implementedrobotics/Nomad/Hardware/Actuator/NomadBLDC/PCBV1.3_CSD/3d_partially_populated.png

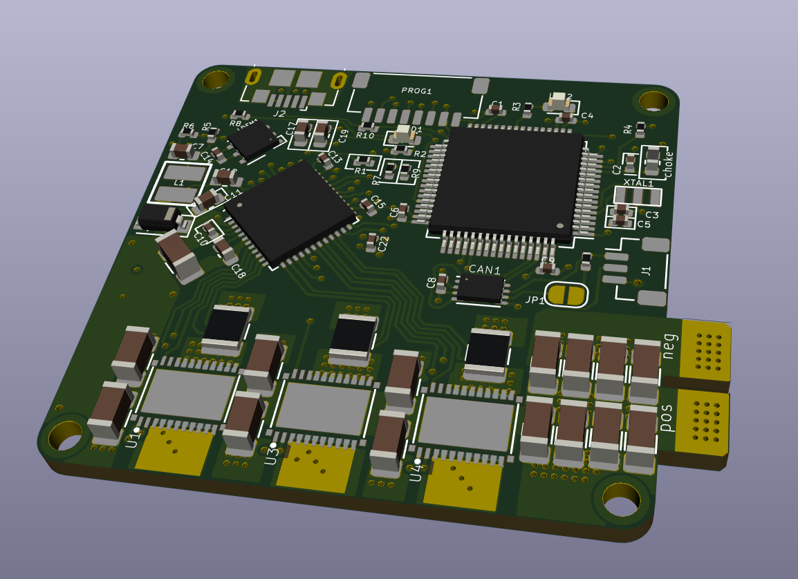
Hardware/Actuator/NomadBLDC/PCBV1.3_CSD/3d_partially_populated.png
