implementedrobotics/Nomad/README.md

# NOMAD
NOMAD is a 12-DOF quadruped walking robot using Linear and Nonlinear Optimization Control techniques.

  - Linear and Nonlinear Model Predictive Control
  - Simultaneous Localization and Mapping
  - Remote Control Teleoperation

# Software Installation

First thing to do is setup your software/development environment to build the source code:
[Software Setup](https://github.com/implementedrobotics/Nomad/tree/master/Software).

# Hardware Installation
