implementedrobotics/Nomad/Hardware/Actuator/NomadBLDC/PCBV1.3_CSD/README.md

# File structure
* Directory - KICAD
** Contains all files for the kicad project
* Directory - KICAD_READERS
** python macros that generated BOM lists for PCBA
* Directory - GERBERS
** plots for PCBA

# Updates from original BK board
* converted from eagle to kicad
* re-routed nearly all traces
* added [CSD88599Q5DC](http://www.ti.com/lit/ds/symlink/csd88599q5dc.pdf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) half-bridge FET
* added more caps
* added power terminal tabs for easier soldering
* added jumper to enable/disable 120 ohm CAN terminating resistor
* added USB connector
* added I/O pin to programming connector
* simplified mask to read all components
