implementedrobotics/Nomad/Hardware/Actuator/NomadBLDC/PCBV1.3_CSD/PCB_LAYERS.pdf

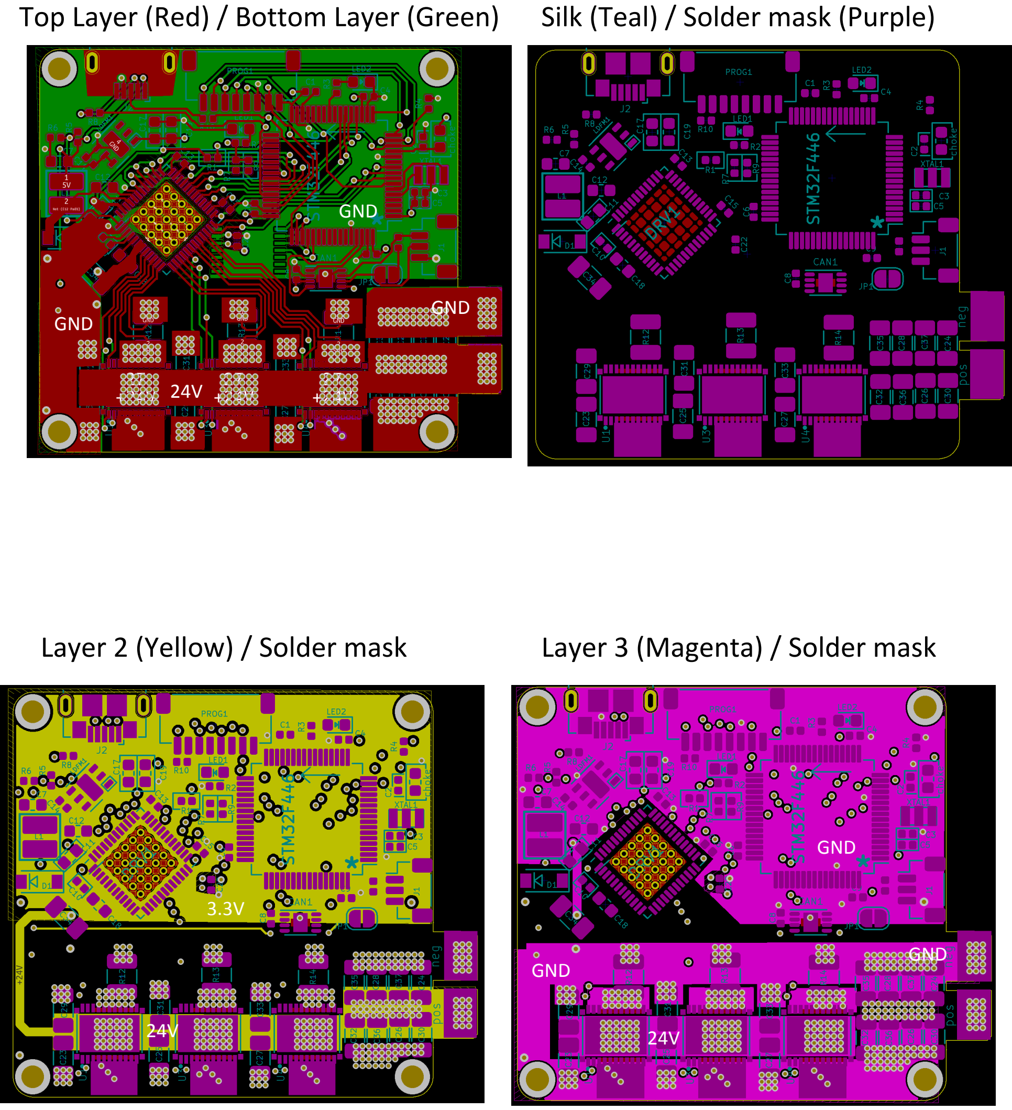
[picture p2: page 1]

Top Layer (Red) / Bottom Layer (Green) Silk (Teal) / Solder mask (Purple)

Layer 2 (Yellow) / Solder mask | Layer 3 (Magenta) / Solder mask

GND

24V

GND

GND

3.3V

24V

GND

24V

GND

GND
