implementedrobotics/Nomad/Hardware/Actuator/NomadBLDC/PCBV1.3_CSD/BOM_PCBWay.xlsx

Source | /Users/owhite/Documents/kicad/PCB_V1.3_CSD/PCB_V1.3_CSD.sch
Date: | Saturday, October 05, 2019 at 09:08:56 PM
Tool: | Eeschema (5.1.4-0-10_14)
Generator: | ./kicad_BOM.py
Component Count: | 66
width (mm): | 43.1
height (mm): | 40.96
Collated Components: | 29
Item # | *Ref Des | *Qty | Manufacturer | *Mfg Part # | Description / Value | *Package | Type | Your Instructions / Notes
1 | C1 | 1 | Murata Electronics | GRM155R60J475ME87D | 4.7uF | C0402 | SMD
2 | C2, C4, C5, C6, C8, C9, C15, C22 | 8 | KEMET | C0402C104K8PAC7411 | 0.1uF | C0402 | SMD
3 | C3, C13 | 2 | KEMET | C0402C105K8PACTU | 1uF | C0402 | SMD
4 | C7 | 1 | Murata Electronics | GRM188R61A226ME15J | 22uF | C0603 | SMD
5 | C10 | 1 | Yageo | CC0402JRX7R9BB473 | 47nF, 50v | C0402 | SMD
6 | C11, C12 | 2 | Yageo | CC0603JRX7R9BB104 | .1uF, 50v | C0603 | SMD
7 | C14 | 1 | KEMET | C0402C105K8PACTU | 1uf | C0402 | SMD
8 | C17, C19 | 2 | Murata Electronics | GRM188R61A226ME15J | 22uf | C0603 | SMD
9 | C18 | 1 | TDK | CGA3E3X5R1H105K080AB | 1uF, 50v | C0603 | SMD
10 | C23, C24, C25, C26, C27, C28, C29, C30, C31, C32, C33, C34, C35, C36, C37 | 15 | Murata Electronics | GRT31CR61H106ME01L | 10uF, 50v | C1206 | SMD
11 | CAN1 | 1 | Microchip Technology | MCP2542FDT-H/MNY | MCP2542 | TDFN-8 | SMD
12 | CHOKE1 | 1 | Pulse Electronics | PE-0603FB601ST | 600r | L0603 | SMD
13 | D1 | 1 | Diodes Incorporated | MBR0580S1-7 | DIODE | DSOD-123 | SMD
14 | DRV1 | 1 | Texas Instruments | DRV8323RSRGZT | DRV8323RH | TexasS-PVQFN-N48EP5.15x5.15mmIslands | SMD
15 | J1 | 1 | JST Sales America Inc. | BM03B-SURS-TF(LF)(SN) | Conn_01x03 | JSTSHBM03B-SRSS-TB1x03-1MPP1.00mmVertical | SMD
16 | J2 | 1 | GCT | USB3076-30-A | USB_B_Micro | USBMicro-BGCTUSB3076-30-A | SMD
17 | L1 | 1 | Taiyo Yuden | NRH3012T220MNV | 22uH | SDR0302 | SMD
18 | LDFM1 | 1 | STMicroelectronics | LDFM33PUR | LDFM | DFN-6 | SMD
19 | LED1, LED2 | 2 | Lite-On | LTST-C191KRKT | LED | LED0603 | SMD
20 | PROG1 | 1 | JST Sales America Inc. | SM08B-SRSS-TB(LF)(SN) | Conn_01x08 | JSTSHSM08B-SRSS-TB1x08-1MPP1.00mmHorizontal | SMD
21 | R1 | 1 | Yageo | RC0402DR-07150KL | 150k | R0402 | SMD
22 | R2, R3, TERM1 | 3 | Yageo | RC0402JR-07200RL | 200 | R0402 | SMD
23 | R4, R6, R7, R9 | 4 | Yageo | RT0402DRE0710KL | 10k | R0402 | SMD
24 | R5 | 1 | Yageo | RC0402FR-0754K9L | 54.9k | R0402 | SMD
25 | R8, R10 | 2 | Yageo | RC0402JR-0722RL | 22 | R0402 | SMD
26 | R12, R13, R14 | 3 | ROHM Semiconductor | PMR25HZPFV1L00 | 0.001 | R1210 | SMD
27 | STM1 | 1 | STMicroelectronics | STM32F446RET6 | STM32F446RET6 | TQFP-64 | SMD
28 | U1, U3, U4 | 3 | Texas Instruments | CSD88599Q5DC | CSD88599Q5DC | MOSFETCSD88599Q5DC | SMD
29 | XTAL1 | 1 | Murata Electronics | CSTNE8M00GH5L000R0 | CSTCE | CSTCE | SMD
