implementedrobotics/Nomad/Hardware/Actuator/NomadBLDC/PCB_V1.2/BOMs/BLDC_BOM_OW.xlsx

Sheet: SORTED
BK_PARTS refers to Ben Katz's original BOM
NUMBER | BK_PARTS | V1.2 | VALUE | PACKAGE
1 | R2, R3, R4 R27 | R1, R2, R5, R6 | 10k | R0402 | LINK (https://www.mouser.com/ProductDetail/603-RT0402DRE0710KL)
2 | R26 | R3 | 150k | R0402 | LINK (https://www.mouser.com/ProductDetail/603-RC0402DR-07150KL)
3 | R5, R22 | R9, R10 | 200ohm | R0402 | LINK (https://www.mouser.com/ProductDetail/603-RC0402JR-07200RL)
4 | R1 | R4 | 54.9k | R0402 | LINK (https://www.mouser.com/ProductDetail/603-RC0402FR-0754K9L)
5 | R6, R7 | R7, R8 | 0.001 | R1210 | LINK (https://www.mouser.com/ProductDetail/755-PMR25HZPFV1L00)
6 | C18, C27, C31, C32, C33, C34, C41, VREFCAP, VCAP1, VCAP2, VCAP3 | C26, C20, C21, C22, C28, C27, C11, C18, VCAP1, VCAP2, VCAP3 | .1uF 10v | C0402 | LINK (https://www.mouser.com/ProductDetail/80-C0402C104K8P7411)
7 | C1, C8, C11, C12, C13, C14, C15, C16 | C1, C2, C3, C4, C5, C6, C7, C8 | 10uF 50v | C1206 | LINK (https://www.mouser.com/ProductDetail/81-GRT31CR61H106ME1L)
8 | C5 | C14 | 47nF 50v | C0402 | LINK (https://www.mouser.com/ProductDetail/603-CC0402JRX79BB473)
9 | C7, C10, MC1 | C15, C19, C23 | 1uF 10v X5R/X7R | C0402 | LINK (https://www.mouser.com/ProductDetail/80-C0402C105K8P)
10 | C9 | C17 | 4.7uF 10v | C0402 | LINK (https://www.mouser.com/ProductDetail/81-GRM155R60J475ME8D)
11 | LED1, LED2 |  | LED1, LED2 | LED0603 | LED (https://www.mouser.com/ProductDetail/859-LTST-C191KRKT)
12 | C2, C4 | C10, C13 | .1uF 50v | C0603 | LINK (https://www.mouser.com/ProductDetail/603-CC603JRX7R9BB104)
13 | C6 | C16 | 1 uF 50v | C0603 | LINK (https://www.mouser.com/ProductDetail/810-CGA3E3X5R1H105K)
14 | C3 | C12 | 22uF 10v | C0603 | LINK (https://www.mouser.com/ProductDetail/81-GRM188R61A226ME5J)
15 | C19, C20 | C24, C25 | 22uF ?? | C0603 | LINK | These require testing for the VLDO
16 | C17 | C9 | 10uF 50v | C1206 | LINK (https://www.mouser.com/ProductDetail/81-GRT31CR61H106ME1L)
17 | D1 |  | 500 mA 60v | SOD123 | DIODE (https://www.mouser.com/ProductDetail/621-MBR0580S1-7)
18 | L1 |  | 22uH inductor | SDR0302 | L1 (https://www.mouser.com/ProductDetail/963-NRH3012T220MNV)
19 | CHOKE |  | 600r | 603 | CHOKE (https://www.mouser.com/ProductDetail/673-PE-0603FB601ST)
20 | XTAL |  | 8 Mhz | CSTCE | XTAL (https://www.mouser.com/ProductDetail/81-CSTNE8M00GH5L000R)
21 | DRIVER |  | DRV8323RH |  | DRV8323RH (https://www.mouser.com/ProductDetail/595-DRV8323RSRGZT)
22 | LDFM LDFM33PUR |  | LDFM |  | LDFM33PUR (https://www.mouser.com/ProductDetail/511-LDFM33PUR)
23 | CAN INTERFACE |  | MCP2542 | TDFN | MCP2542 (https://www.mouser.com/ProductDetail/579-MCP2542FDT-H-MNY)
24 | ENCODER |  | AS5147 | TSSOP14 | AS5147 (https://www.mouser.com/ProductDetail/985-AS5147P-HTSM)
25 | STM32 |  | STM32F446RET6 | TQFP64 | STM32F446RET6 (https://www.mouser.com/ProductDetail/511-STM32F446RET6)
26 | Q1, Q2, Q3, Q4, Q5, Q6 |  | MOSFET | Power SO8 | TPH2R506PL (https://www.mouser.com/ProductDetail/757-TPH2R506PLL1Q)
27 | SER1 |  | 3-PIN | BM03B-SURS-TF (https://www.digikey.com/product-detail/en/jst-sales-america-inc/BM03B-SURS-TF-LF-SN/455-3586-1-ND/9921993) | BM03B-SURS-TF
28 | PROG |  | 8-PIN | SM08B-SRSS-TB (https://www.digikey.com/product-detail/en/jst-sales-america-inc/SM08B-SRSS-TB-LF-SN/455-1808-1-ND/926879) | SM08B-SRSS-TB

Sheet: BK_LIST
 | Supplied Parts |  |  |  |  |  | CHECKED FOOTPRINT
Parts | Qty Per Board | Value | Device | Package | Parts | MFG Part |  | NOT AT MOUSER - DIGIKEY
U$1 | 1 | DRV8323RH | DRV8323RH | QFN50P700X700X90-49N | U$1 | ‎DRV8323RSRGZT‎ | no
LED1, LED2 | 2 | G | LED0603 | LED-0603 | LED1, LED2 | LTST-C191KRKT‎ | yes
LDFM33PUR | 1 | 3.3V 500 mA LDO | LDFM | DFN6-3X3 | LDFM33PUR | ‎LDFM33PUR‎ | yes
U$9 | 1 | AS5147 | AS5147 | TSSOP14 | U$9 | AS5147P
U$6 | 1 | MCP2542 | MCP2542 | TDFN | U$6 | ‎MCP2542FDT-H/MNY‎ | PROBLEM
PROG | 1 | SM07B-SRSS-TB | SM07B-SRSS-TB | R1210 | PROG | ‎SM07B-SRSS-TB(LF)(SN)‎ |  | 455-1807-1-ND | JST connector
U$3 | 1 | STM32F446RET6 | STM32F446RET6 | TQFP64 | U$3 | ‎STM32F446RET6‎
Q1, Q2, Q3, Q4, Q5, Q6 | 6 | 60V | MOSFET | Power SO8 | Q1, Q2, Q3, Q4, Q5, Q6 | ‎TPH2R506PL,L1Q‎ | yes
C1, C8, C11, C12, C13, C14, C15, C16, C17, C21, C22, C23, C24, C25, C26, C28, C29 | 9 | 10 uF 50v | C-USC1206K | C1206K | C1, C8, C11, C12, C13, C14, C15, C16, C17, C21, C22, C23, C24, C25, C26, C28, C29 | GRT31CR61H106ME01L
L1 | 1 | 22uH 500 mA | SDR0302 | SDR0302 | L1 | ‎NRH3012T220MN‎ | yes
R6, R7 | 2 | 0.001 | R-US_R1210 | R1210 | R6, R7 | ‎PMR25HZPFV1L00‎
CHOKE | 1 | 600r | INDUCTOR0603 | 603 | CHOKE | ‎PE-0603FB601ST‎
XT1 | 1 | 8 Mhz Ceramic Resonator | CSTCE | CSTCE | XT1 | ‎CSTNE8M00GH5L000R0‎
D1 | 1 | 500 mA 60v | DIODE-SOD123 | SOD123 | D1 | ‎MBR0580S1-7‎ | yes
C18, C27, C31, C32, C33, C34, C41, VREFCAP | 8 | .1 uF 10v X5R/X7R | C-USC0402K | C0402K | C18, C27, C31, C32, C33, C34, C41, VREFCAP | ‎CL05A104MP5NNNC | yes | 1276-1443-2-ND | MOUSER REPLACEMENT: 80-C0402C104K8P7411
C2, C4 | 2 | .1 uF 50v X5R/X7R | C-USC0603K | C0603K | C2, C4 | ‎CC0603JRX7R9BB104‎
C7, C10, MC1 | 3 | 1 uF 10v X5R/X7R | C-USC0402K | C0402K | C7, C10, MC1 | ‎CL05A105MP5NNNC‎ |  | 1276-1448-2-ND
C6 | 1 | 1 uF 50v X5R/X7R | C-USC0603K | C0603K | C6 | ‎CL10A105KB8NNNC‎ |  |  | MOUSER: replacement 80-C0402C105K8P
R2, R3, R4 R27 | 4 | 10k 1% | R-US_R0402 | R0402 | R2, R3, R4 R27 | ‎RT0402DRE0710KL‎
R26 | 1 | 150k 1% | R-US_R0402 | R0402 | R26 | ‎RMCF0402FT150K‎
R5, R22 | 2 | 200 5% | R-US_R0402 | R0402 | R5, R22 | ‎RC0402JR-07200RL‎
C3, C19, C20 | 3 | 22 uF 10v X5R/X7R | C-USC0603K | C0603K | C3, C19, C20 | ‎CL10A226MPCNUBE‎ |  | 1276-6504-2-ND | Mouser replacement: 81-GRM188R61A226ME5J
C9 | 1 | 4.7 uF 10v X5R/X7R | C-USC0402K | C0402K | C9 | ‎GRM155R60J475ME87D‎
C5 | 1 | 47 nF 50v X5R/X7R | C-USC0402K | C0402K | C5 | ‎CGA2B3X7R1H473M050BD‎
R1 | 1 | 54.9k 1% | R-US_R0402 | R0402 | R1 | ‎RC0402FR-0754K9L‎
SER1 | 1 | 3-Pin |  | SM03B-SRSS-TB | SER1 | SM03B-SRSS-TB |  | 455-1803-2-ND | JST

Sheet: DIFF
NUMBER FROM BK LIST | NUMBER FROM EAGLE | Value | Package | THESE ON BK LIST NOT ON EAGLE | THESE ON EAGLE NOT ON BK LIST
C1 | C1 | 10 | C1206K
C2 | C2 | .1 uF | C0603K | C21 | YCAP1
C3 | C3 | 22 uF | C0603K | C22 | YCAP2
C4 | C4 | .1 uF | C0603K | C23 | YCAP3
C5 | C5 | 47 nF | C0402K | C24
C6 | C6 | 1 uF | C0603K | C25
C7 | C7 | 1 uF | C0402K | C26
C8 | C8 | 10 | C1206K | C28
C9 | C9 | 4.7 | C0402K | C29
C10 | C10 | 1uF | C0402K
C11 | C11 | 10 | C1206K
C12 | C12 | 10 | C1206K
C13 | C13 | 10 | C1206K
C14 | C14 | 10 | C1206K
C15 | C15 | 10 | C1206K
C16 | C16 | 10 | C1206K
C17 | C17 | .1 uF | C1206K
C18 | C18 | .1 uF | C0402K
C19 | C19 | 22uf | C0603K
C20 | C20 | 22uf | C0603K
C27 | C27 | 100nF | C0402K
C31 | C31 | 100nF | C0402K
C32 | C32 | 100nF | C0402K
C33 | C33 | .1 uF | C0402K
C34 | C34 | .1 uF | C0402K
C41 | C41 | 100nF | C0402
CHOKE | CHOKE | 600r | 603
D1 | D1 |  | SOD123
L1 | L1 | 22uH | SDR0302
LED1 | LED1 | G | LED-0603
LED2 | LED2 | G | LED-0603
MC1 | MC1 | 1uf | C0402
PROG | PROG | SM07B-SRSS-TB | SM07B-SRSS-TB
Q1 | Q1 | TPH | TRANS_TPH5900CNH,L1Q
Q2 | Q2 | TPH | TRANS_TPH5900CNH,L1Q
Q3 | Q3 | TPH | TRANS_TPH5900CNH,L1Q
Q4 | Q4 | TPH | TRANS_TPH5900CNH,L1Q
Q5 | Q5 | TPH | TRANS_TPH5900CNH,L1Q
Q6 | Q6 | TPH | TRANS_TPH5900CNH,L1Q
R1 | R1 | 54.9k | R0402
R2 | R2 | 10k | R0402
R3 | R3 | 10k | R0402
R4 | R4 | 10k | R0402
R5 | R5 | 200 | R0402
R6 | R6 | 0.001 | R1210
R7 | R7 | 0.001 | R1210
R22 | R22 | 200 | R0402
R26 | R26 | 150k | R0402
R27 | R27 | 10k | R0402
SER1 | SER1 | SM03B-SRSS-TB | SM03B-SRSS-TB
U$1 | U$1 | DRV8323RH | QFN50P700X700X90-49N
 | U$2 | 18_AWG_PAD | 18_AWG_PAD | *** note these just seem like something weird out of eagle
U$3 | U$3 | STM32F446RET6 | TQFP64
 | U$4 | 18_AWG_PAD | 18_AWG_PAD | ***
 | U$5 | 18_AWG_PAD | 18_AWG_PAD | ***
U$6 | U$6 | MCP2542 | TDFN
LDFM33PUR | U$7 | LDFM | DFN6-3X3
 | U$8 | 18_AWG_PAD | 18_AWG_PAD | ***
U$9 | U$9 | AS5047P | TSSOP14
 | U$10 | 18_AWG_PAD | 18_AWG_PAD | ***
VREFCAP | VREFCAP | 100nF | C0402K
XT1 | XT1 | CSTCE | CSTCE
 | YCAP1 | 100nF | C0402K
 | YCAP2 | 100nF | C0402K
 | YCAP3 | 100nF | C0402K
