implementedrobotics/Nomad/Software/Resource/LegTest/meshes/KFE_Actuaor1.stl

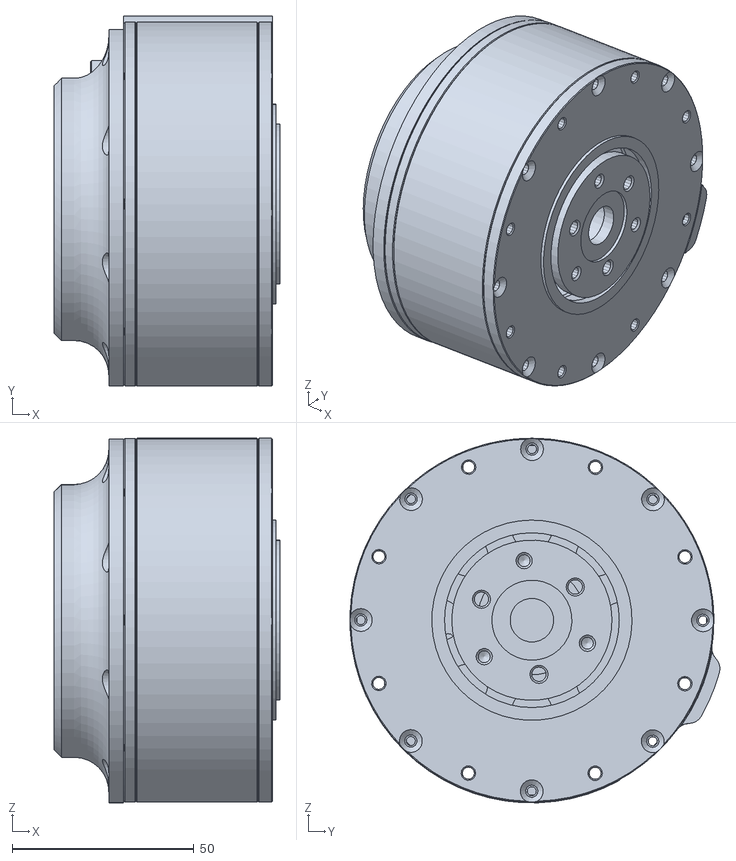
[picture p3: CAD file, 2021-04-23]
Software/Resource/LegTest/meshes/KFE_Actuaor1.stl
62.0 x 101.7 x 100.2
