implementedrobotics/Nomad/Software/Resource/Robot_V2/meshes/b_lower_leg_RR1.stl

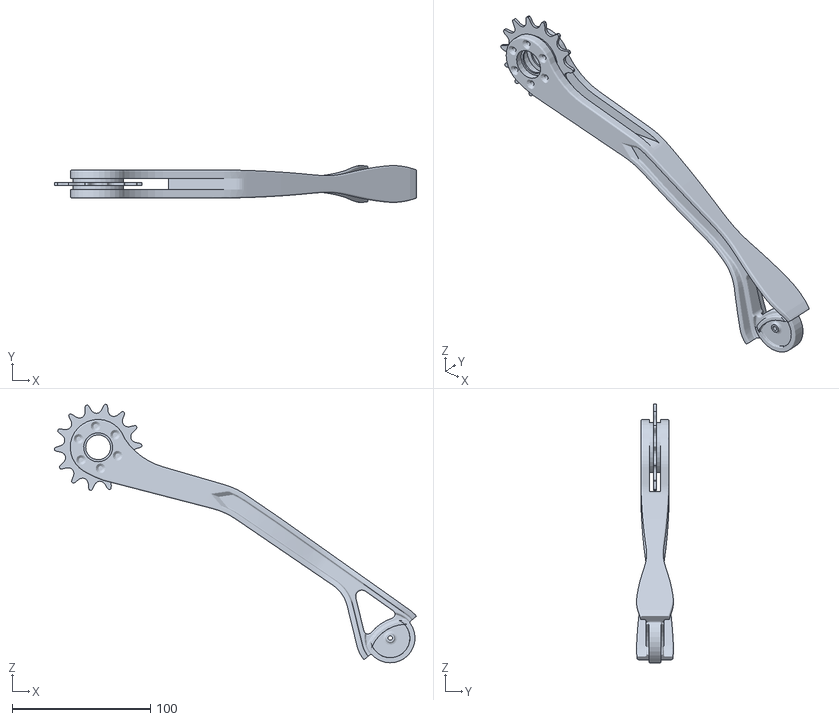
[picture p4: CAD file, 2021-04-23]
Software/Resource/Robot_V2/meshes/b_lower_leg_RR1.stl
262.3 x 26.6 x 187.4
