implementedrobotics/Nomad/Software/Simulation/Gazebo/models/Nomad/meshes/b_upper_leg_FR.stl

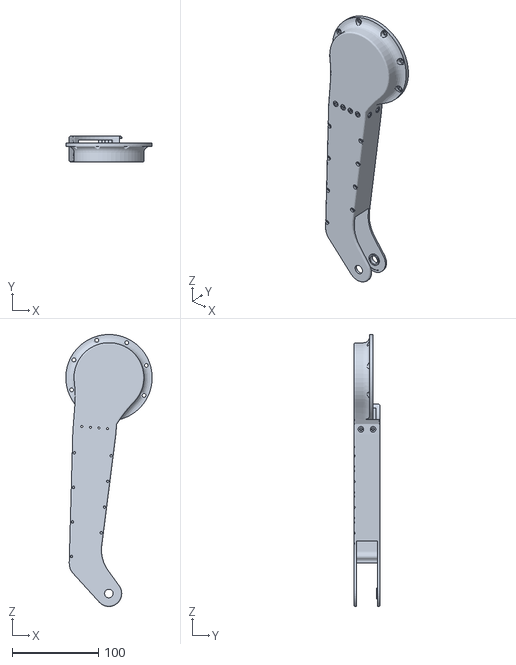
[picture p5: CAD file, 2020-08-11]
Software/Simulation/Gazebo/models/Nomad/meshes/b_upper_leg_FR.stl
100.0 x 30.0 x 315.0
