implementedrobotics/Nomad/Software/Resource/LegTest/meshes/base_link.stl

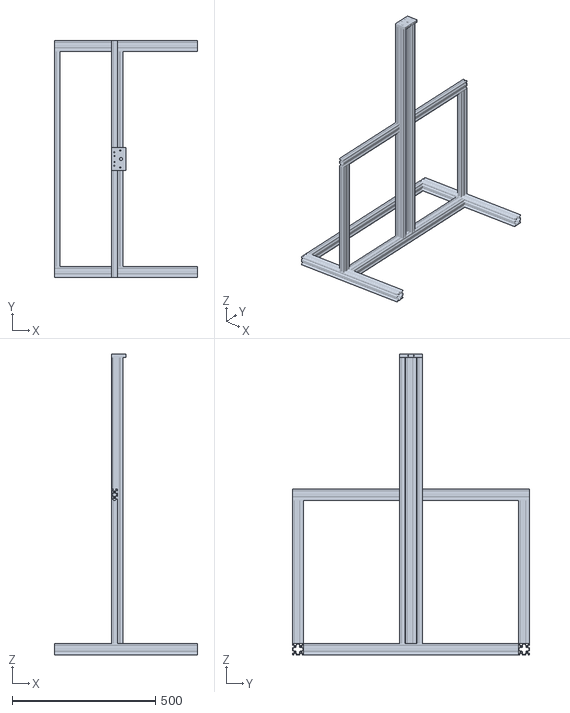
[picture p6: CAD file, 2021-04-23]
Software/Resource/LegTest/meshes/base_link.stl
500.0 x 830.0 x 1052.0
