implementedrobotics/Nomad/Software/Resource/Robot_V2/meshes/b_haa_motor_FL1.stl

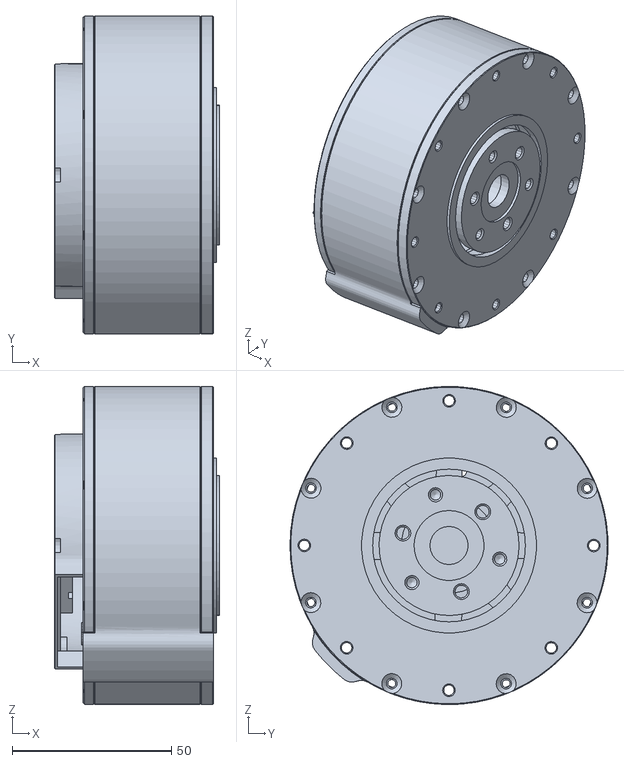
[picture p7: CAD file, 2021-04-23]
Software/Resource/Robot_V2/meshes/b_haa_motor_FL1.stl
52.0 x 100.0 x 100.0
