implementedrobotics/Nomad/Software/Simulation/Gazebo/models/Nomad/meshes/b_haa_motor_FR.stl

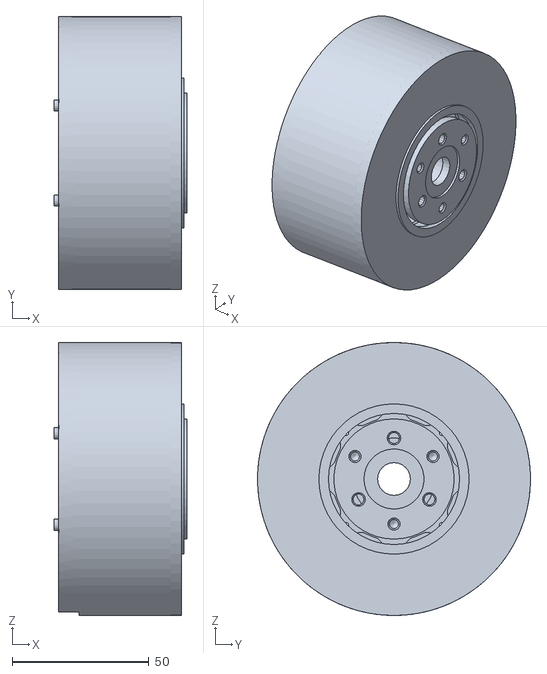
[picture p8: CAD file, 2020-08-11]
Software/Simulation/Gazebo/models/Nomad/meshes/b_haa_motor_FR.stl
48.7 x 100.0 x 100.0
