implementedrobotics/Nomad/Software/Resource/LegTest/meshes/Upper_Leg1.stl

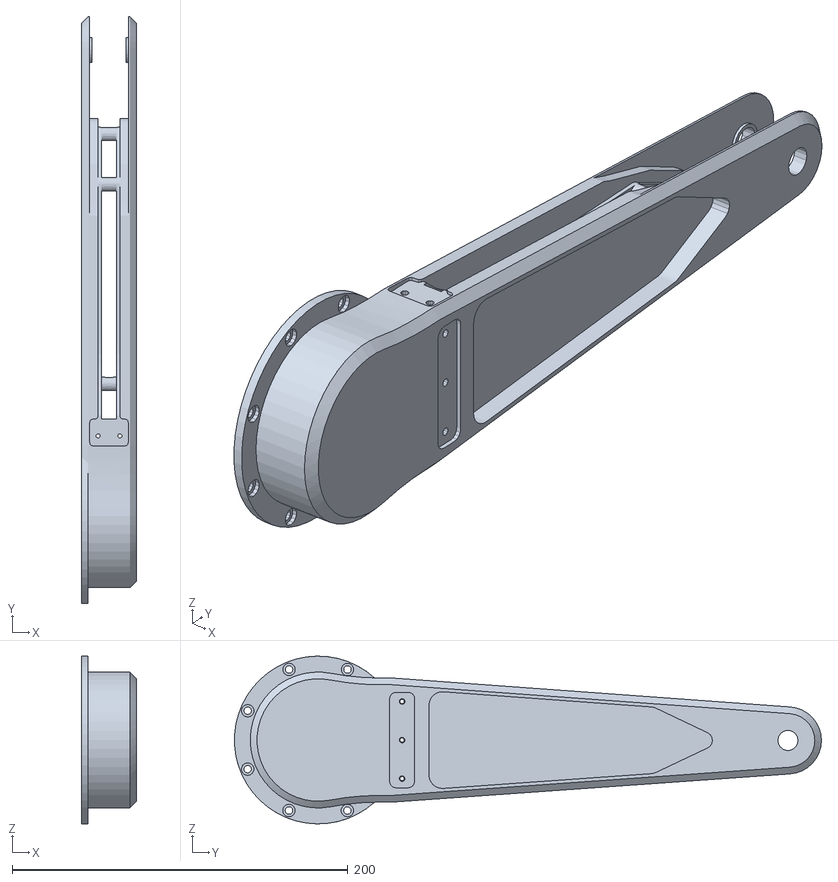
[picture p9: CAD file, 2021-04-23]
Software/Resource/LegTest/meshes/Upper_Leg1.stl
33.0 x 349.9 x 100.0
