implementedrobotics/Nomad/Software/Resource/Robot_V2/meshes/b_hfe_motor_RR1.stl

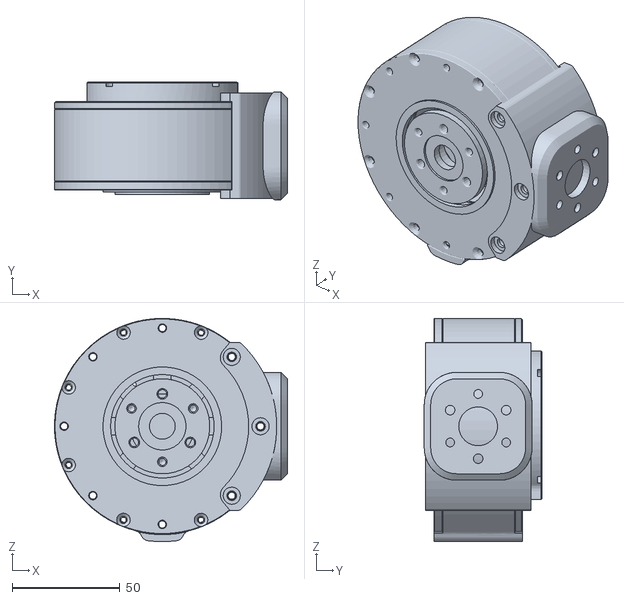
[picture p10: CAD file, 2021-04-23]
Software/Resource/Robot_V2/meshes/b_hfe_motor_RR1.stl
108.0 x 54.5 x 103.5
