implementedrobotics/Nomad/Software/Resource/LegTest/meshes/Foot1.stl

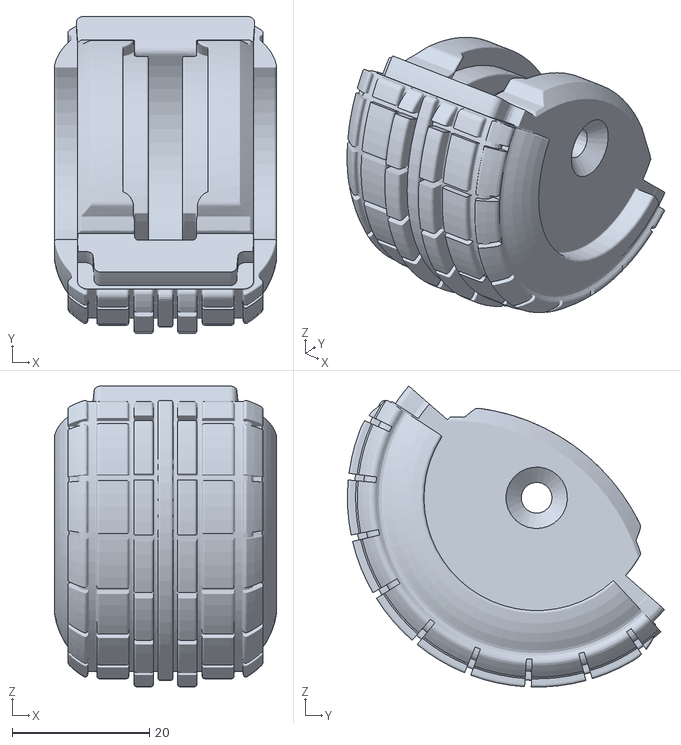
[picture p11: CAD file, 2021-04-23]
Software/Resource/LegTest/meshes/Foot1.stl
32.4 x 46.2 x 43.9
