implementedrobotics/Nomad/Software/Simulation/Gazebo/models/Nomad/meshes/b_foot_RL.stl

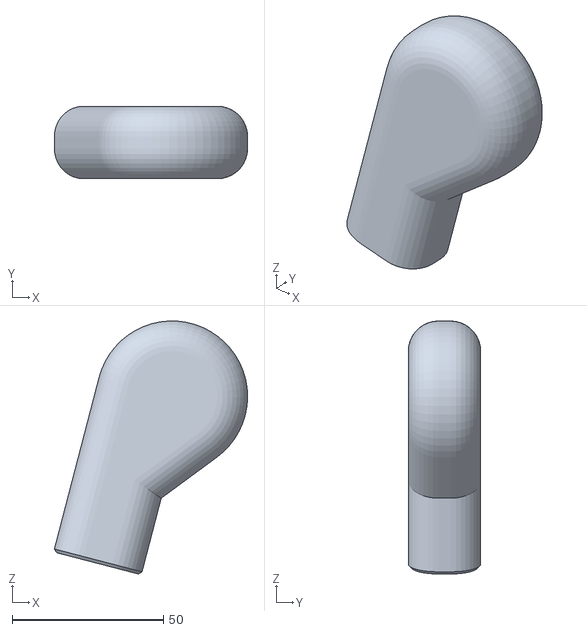
[picture p12: CAD file, 2020-08-11]
Software/Simulation/Gazebo/models/Nomad/meshes/b_foot_RL.stl
64.0 x 24.0 x 83.8
