implementedrobotics/Nomad/Software/Resource/LegTest/meshes/Slider_Plate1_1.stl

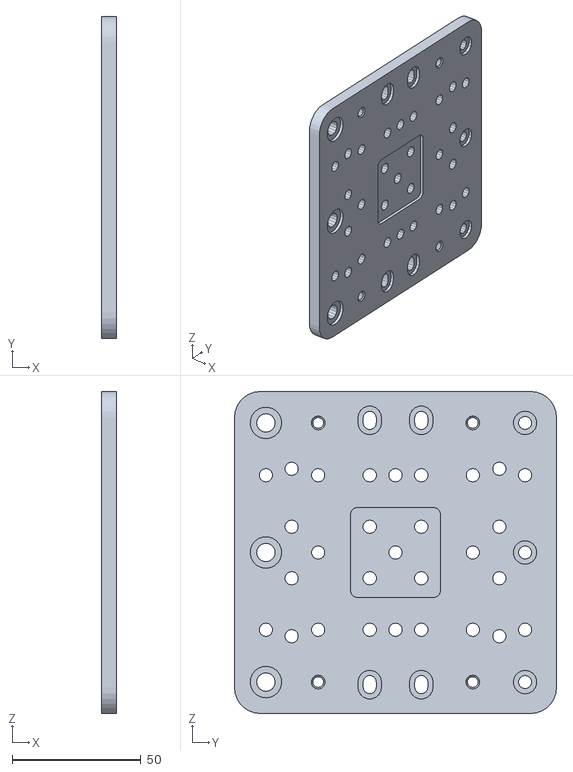
[picture p13: CAD file, 2021-04-23]
Software/Resource/LegTest/meshes/Slider_Plate1_1.stl
6.00 x 125.0 x 125.0
