implementedrobotics/Nomad/Software/Resource/LegTest/meshes/Lower_Leg1.stl

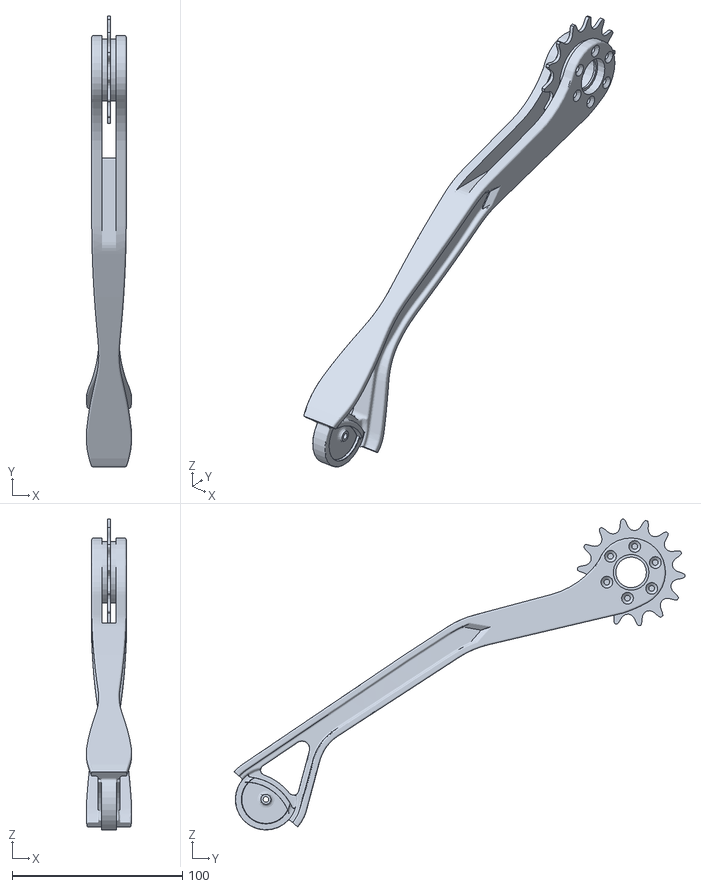
[picture p14: CAD file, 2021-04-23]
Software/Resource/LegTest/meshes/Lower_Leg1.stl
26.6 x 264.9 x 182.8
