implementedrobotics/Nomad/Software/Resource/Robot_V2/meshes/b_foot_RL1.stl

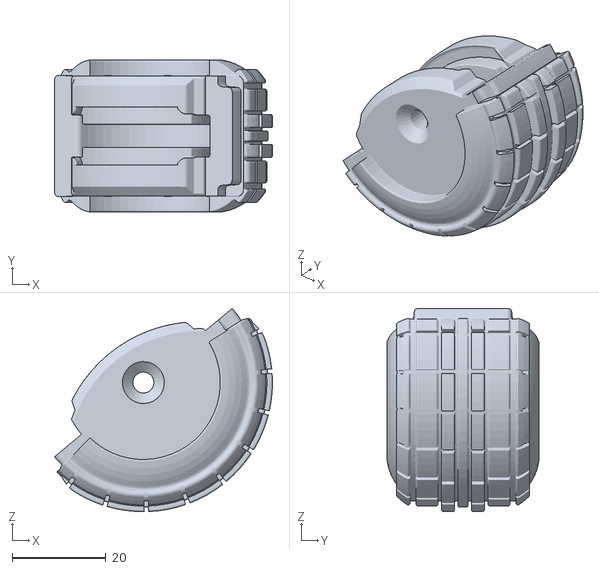
[picture p15: CAD file, 2021-04-23]
Software/Resource/Robot_V2/meshes/b_foot_RL1.stl
46.6 x 32.4 x 43.5
