implementedrobotics/Nomad/Software/Simulation/Gazebo/models/Nomad/meshes/b_kfe_motor_FR.stl

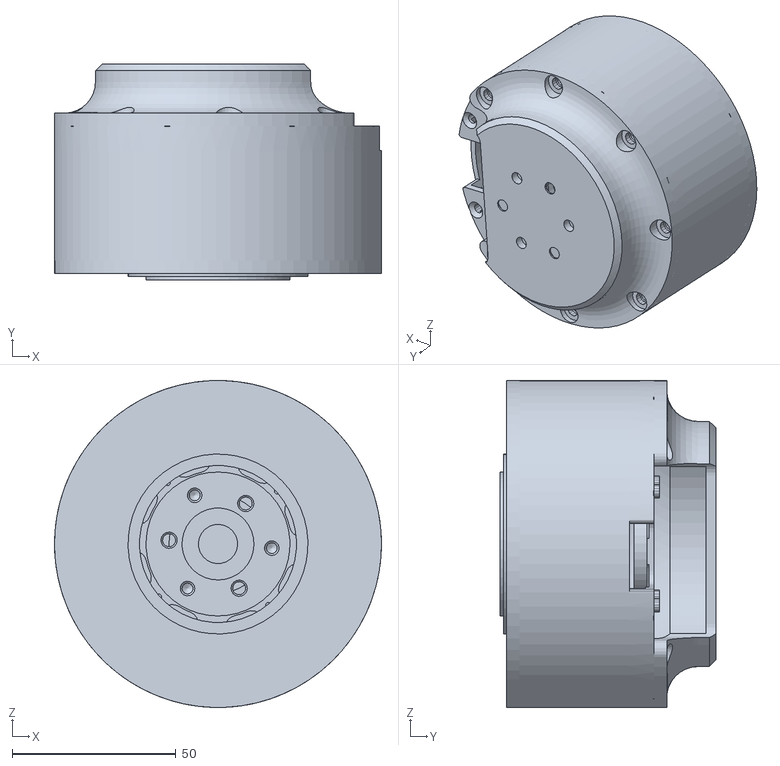
[picture p16: CAD file, 2020-08-11]
Software/Simulation/Gazebo/models/Nomad/meshes/b_kfe_motor_FR.stl
100.0 x 66.0 x 100.0
