implementedrobotics/Nomad/Software/Simulation/Gazebo/models/Nomad/meshes/b_lower_leg_FR.stl

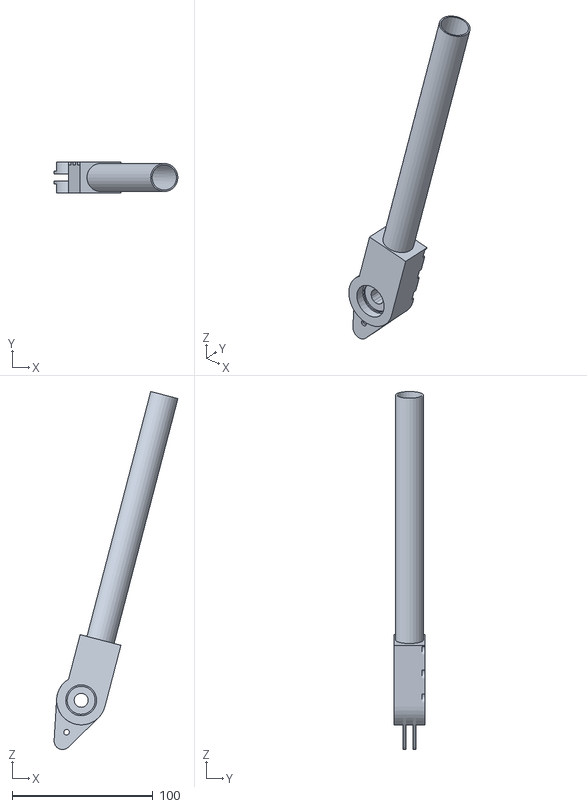
[picture p17: CAD file, 2020-08-11]
Software/Simulation/Gazebo/models/Nomad/meshes/b_lower_leg_FR.stl
88.1 x 22.0 x 254.6
