implementedrobotics/Nomad/Software/Resource/Robot_V2/meshes/base_link.stl

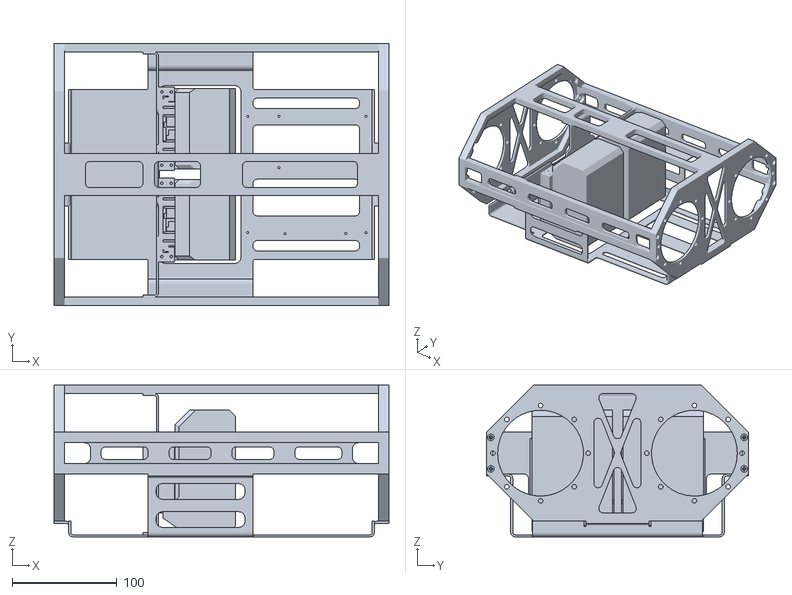
[picture p18: CAD file, 2021-04-23]
Software/Resource/Robot_V2/meshes/base_link.stl
320.0 x 250.0 x 145.0
