implementedrobotics/Nomad/Software/Simulation/Gazebo/models/Nomad/meshes/b_hfe_motor_FR.stl

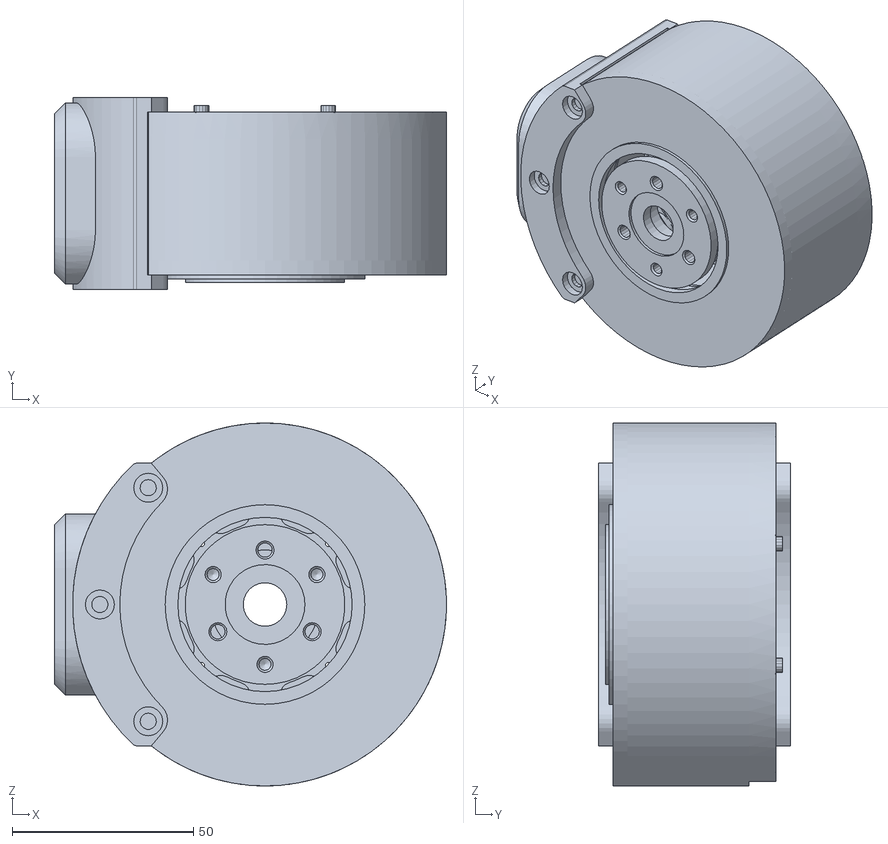
[picture p19: CAD file, 2020-08-11]
Software/Simulation/Gazebo/models/Nomad/meshes/b_hfe_motor_FR.stl
108.0 x 53.0 x 100.0
