implementedrobotics/Nomad/Software/Simulation/Gazebo/models/Nomad/meshes/base_link.stl

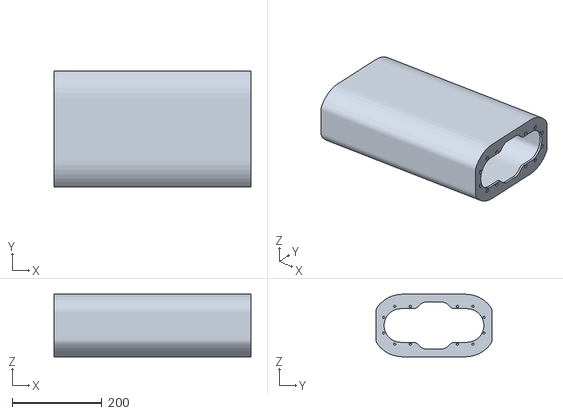
[picture p20: CAD file, 2020-08-11]
Software/Simulation/Gazebo/models/Nomad/meshes/base_link.stl
440.0 x 260.0 x 140.0
