implementedrobotics/Nomad/(list of files, cad)

Other CAD files:
Software/Simulation/Gazebo/models/Nomad/meshes/b_upper_leg_RR.stl
Software/Resource/Robot_V2/meshes/b_haa_motor_RR1.stl
Software/Resource/LegTest/meshes/HFE_Actuator1.stl
Software/Resource/Robot_V2/meshes/b_lower_leg_FR1.stl
Software/Simulation/Gazebo/models/Nomad/meshes/b_foot_RR.stl
Software/Resource/Robot_V2/meshes/b_hfe_motor_FR1.stl
Software/Simulation/Gazebo/models/Nomad/meshes/b_upper_leg_FL.stl
Software/Resource/Robot_V2/meshes/b_kfe_motor_RR1.stl
Software/Simulation/Gazebo/models/Nomad/meshes/b_upper_leg_RL.stl
Software/Resource/Robot_V2/meshes/b_upper_leg_FR1.stl
Software/Resource/Robot_V2/meshes/b_kfe_motor_FR1.stl
Software/Simulation/Gazebo/models/Nomad/meshes/b_haa_motor_RR.stl
Software/Simulation/Gazebo/models/Nomad/meshes/b_lower_leg_FL.stl
Software/Resource/Robot_V2/meshes/b_upper_leg_RR1.stl
Software/Simulation/Gazebo/models/Nomad/meshes/b_haa_motor_FL.stl
Software/Resource/Robot_V2/meshes/b_haa_motor_FR1.stl
Software/Simulation/Gazebo/models/Nomad/meshes/b_lower_leg_RL.stl
Software/Resource/Robot_V2/meshes/b_upper_leg_RL1.stl
Software/Resource/Robot_V2/meshes/b_lower_leg_FL1.stl
Software/Simulation/Gazebo/models/Nomad/meshes/b_lower_leg_RR.stl
Software/Resource/Robot_V2/meshes/b_upper_leg_FL1.stl
Software/Simulation/Gazebo/models/Nomad/meshes/b_hfe_motor_RL.stl
Software/Resource/Robot_V2/meshes/b_foot_FL1.stl
Software/Simulation/Gazebo/models/Nomad/meshes/b_hfe_motor_RR.stl
Software/Resource/Robot_V2/meshes/b_hfe_motor_RL1.stl
Software/Resource/Robot_V2/meshes/b_haa_motor_RL1.stl
Software/Simulation/Gazebo/models/Nomad/meshes/b_kfe_motor_RR.stl
Software/Resource/Robot_V2/meshes/b_hfe_motor_FL1.stl
Software/Simulation/Gazebo/models/Nomad/meshes/b_kfe_motor_RL.stl
Software/Resource/Robot_V2/meshes/b_lower_leg_RL1.stl
Software/Simulation/Gazebo/models/Nomad/meshes/b_foot_FR.stl
Software/Resource/Robot_V2/meshes/b_kfe_motor_RL1.stl
Software/Simulation/Gazebo/models/Nomad/meshes/b_kfe_motor_FL.stl
Software/Resource/Robot_V2/meshes/b_kfe_motor_FL1.stl
Software/Simulation/Gazebo/models/Nomad/meshes/b_haa_motor_RL.stl
Software/Resource/Robot_V2/meshes/b_foot_RL2.stl
Software/Simulation/Gazebo/models/Nomad/meshes/b_foot_FL.stl
Software/Resource/Robot_V2/meshes/b_foot_FR1.stl
Software/Simulation/Gazebo/models/Nomad/meshes/b_hfe_motor_FL.stl
Software/Resource/Robot/meshes/b_foot_FL.stl
Software/Resource/Robot/meshes/b_foot_FR.stl
Software/Resource/Robot/meshes/b_foot_RR.stl
Software/Resource/Robot/meshes/b_haa_motor_FL.stl
Software/Resource/Robot/meshes/b_haa_motor_RL.stl
Software/Resource/Robot/meshes/b_haa_motor_RR.stl
Software/Resource/Robot/meshes/b_hfe_motor_FL.stl
Software/Resource/Robot/meshes/b_hfe_motor_RL.stl
Software/Resource/Robot/meshes/b_hfe_motor_RR.stl
Software/Resource/Robot/meshes/b_kfe_motor_FL.stl
Software/Resource/Robot/meshes/b_kfe_motor_RL.stl
Software/Resource/Robot/meshes/b_kfe_motor_RR.stl
Software/Resource/Robot/meshes/b_lower_leg_FL.stl
Software/Resource/Robot/meshes/b_lower_leg_RL.stl
Software/Resource/Robot/meshes/b_lower_leg_RR.stl
Software/Resource/Robot/meshes/b_upper_leg_FL.stl
Software/Resource/Robot/meshes/b_upper_leg_RL.stl
Software/Resource/Robot/meshes/b_upper_leg_RR.stl
