implementedrobotics/Nomad/Hardware/Actuator/NomadBLDC/Tools/SETUP.md

Install Notes
sudo update
upgrade pip - pip3 install --upgrade pip
pip3 install pyqt5
pip3 install pyqtchart

sudo apt-get install python3-pyqt5
sudo apt-get install pyqt5-dev-tools
sudo apt-get install qttools5-dev-tools

pip3 install pyserial

update to 3.7
sudo apt-get install python3.7
sudo update-alternatives --install /usr/bin/python3 python3 /usr/bin/python3.6 1
sudo update-alternatives --install /usr/bin/python3 python3 /usr/bin/python3.6 1
sudo update-alternatives --config python3 and select 2
vim /usr/bin/gnome-terminal -> change to python3.6
sudo apt-get install python-apt
