implementedrobotics/Nomad/Hardware/Actuator/NomadBLDC/FirmwareG4/TODO.md

# Firmware TODO:
* Keep alive support/Watchdog
* Add Position Limit Enable - NaN
* Set Control Mode FUNCTION
* CAN Bootloader
* Device Status register access -> MotorControl
* Arm Controller Function
* Gate driver fault checking and reporting ****
* Verify optimization flags -O3 breaks something.  Looks like PWM timers don't start?
* Remove all HAL timers
* Circular Buffer for general use. e.g. HDLC packet receive could be circular.  Right now is linear
* Customize HDLC Command Callback.  And make consistent with CAN Bus once implemented
* FET Thermistor/Motor Thermistor Variables in Config. 
* Adjustable LUT encoder offset size.  Update position sensor % modulus when this happens
* Save stats for loop cycle time if in debug mode etc.
* Error out if missing deadlines etc
* Make RMS Current period configurable?  For now it is 1/10.  Reasonable memory use for 60.0s window.
* Add ErrorTransition FSM Function <- Watchdog here
* Add ADC Start Poll/Read decouple.  Start ADC do other stuff read later
* SPI DMA? ADC DMA?
* Add Theta Electrical + Speed Feedword in FOC
* FD CAN Peripheral Abort Request
* FD CAN Error Handler Function
* Peripheral Base Class
* Add register error check handling lambda/callbacks and scaling
* Verify Good Location of Address Flash Page
* Profile/Optimize CAN Interrupt Handling Function - Fast enough for atleast 1khz
