implementedrobotics/Nomad/Hardware/Actuator/NomadBLDC/Tools/TODO.md

# PC/GUI TODO:
1.  Change calibrate to valid configuration
2.  Torque mode slider
3.  Add timeouts to serial reads properly
4.  Setup for more event based signalling + asyncio
5.  Add Keep Alive Packet
6.  Put motor control modes in timed event/thread for Keep Alive
7.  Add support for checking port still open
8.  Send mutex/locking
9.  Validate active connection to control button events that require a connection
10. Fault status checking
11. Load testing
12. Thermal testing
13. ZMQ for synchronization of threads
14. udev rule for controller?
