implementedrobotics/Nomad/Hardware/Actuator/NomadBLDC/Drivers/CAN/TODO.md

# CAN/C++ Nomad Library TODO:
* Add Async/Sync Modes
* CreateRegisterRequest(address, Data, Return) -> Templated?
* Make Telepresense Test
* Logger Channel
* Multi Packet CAN Support
* Set Position Limits
* Get Device Status
* Need to bail if not setup correctly.  Throw Exception?
* Do we need Shared Futures?
* Test SocketCAN
* Report Bus Utilization in PCANDevice
* PCAN Blocking or Non Blocking Mode?  Need to evaluate best here
