implementedrobotics/Nomad/Hardware/Actuator/NomadBLDC/Tools/GUI/nomad-bldc-app/TODO.md

API CALLS -
GET DEVICES
NOMAD BLDC DEVICE ITEM(S)
NOMAD BLDC DATA MODELS
RECOIL JS?
CONNECT
DISCONNECT
ENABLE TELEMETRY -> DEVICE -> RATE -> REGISTER LIST

BACKEND -
NEED "DEVICE MANAGER" - Holds active/inactive devices. Will idle on disconnect etc
"SCAN" Function, Loop from 1 -> 32 looking for returns. Store them in hash map

ENABLE STREAM -> Device ID -> FREQ -> Registers

Always sync device status?
