implementedrobotics/Nomad/(threads)

Thread 3 (2019-08-12):

Videos or pics about Nomad?

littleggghost, 2019-08-12:
Hi, there
Your work seems great and use all-round techniques.
Could you post some videos that could show the quadruped runs under real or simulation?
That would be help for getting started.
Thanks in advance!

implementedrobotics, 2019-08-12:
Hi,

Thanks for you interest in the project.  If you are able to run the python notebook there is a bit of an animation "simulation" there that gives the general idea of how it works, but I'll admit it's a bit of a mess as this was more of the proof of concept and figuring out how the control algorithms/maths would come together.  As you have probably seen I am actively working to port/bring this all up in C/C++ so I can get some more/better speed guarantees in the controller.

Interesting that you did ask about simulation.  As of yesterday I just started working on the Gazebo(Simulation Environment) tie ins now that I have the minimal amount of a basic framework to finally be able to push this to a simulation environment.  I would say you'll start to see some videos/results of that soon.

Also I will be publishing some of the hardware(electronics and actuator) designs as well.  I am hoping to share some cool/fun updates now that we are through the boring part of creating our framework.

Feel free to ask me any specific questions if you have them.

Thanks!

jmichaux, 2019-08-12:
Will the hardware be open source?

implementedrobotics, 2019-08-12:
Yes that is the plan.  Open source, or COTS parts that tie in.  Of course those I will not have control over the openness of those parts.

Also I will be machining several of the parts in my shop.  These designs will be open as well but you'll be a bit on your own there for manufacturing.  It's not planned to be a 3D printed style design.  It will be CF + aluminum.  You could still adapt the code and techniques to do a variant.  But at my scale and expected loads I don't think it will be the best option.

littleggghost, 2019-08-13:
Thanks for your reply.
The reason why I ask this is there are many dependencies need to be installed. So it would be better to see the effect video first.
Hope your next pushes.

implementedrobotics, 2019-08-13:
Yes it is a little dependency heavy. The early stages of the code development was a bit of a sandbox.  Honestly about half those dependencies will go away since I have narrowed down the needed libraries.

Also I will add to my TODO list to make a installDeps.sh type script to make that easier for others.

Thanks,

littleggghost, 2019-08-13:
Cheers!

Closed 2019-08-13.

Thread 9 (2019-08-13):

Add low level leg controller

implementedrobotics, 2019-08-13:
Need a low level leg controller node.  This will be responsible for sending force/torques as well as the swing leg controller gains to the underlying motor controllers at the actuators.

This node is also responsible for converting desired optimal ground reaction forces from the ConvexMPC controller output to torques at the legs.

Thread 15 (2019-08-14):

Do proper memory locking for the RT application/preallocate memory

implementedrobotics, 2019-08-14:
For a proper RT setup we need to make sure we are avoiding malloc's etc during runtime which would cause jitter and pauses.

Notes: Look into proper mlock_all function.  And make sure any std::vectors are preallocated.

implementedrobotics, 2020-09-29:
Added

Closed 2020-09-29.
