implementedrobotics/Nomad/Hardware/Actuator/NomadBLDC/PCBV1.3_CSD/PCB_V1.3_CSD.pdf

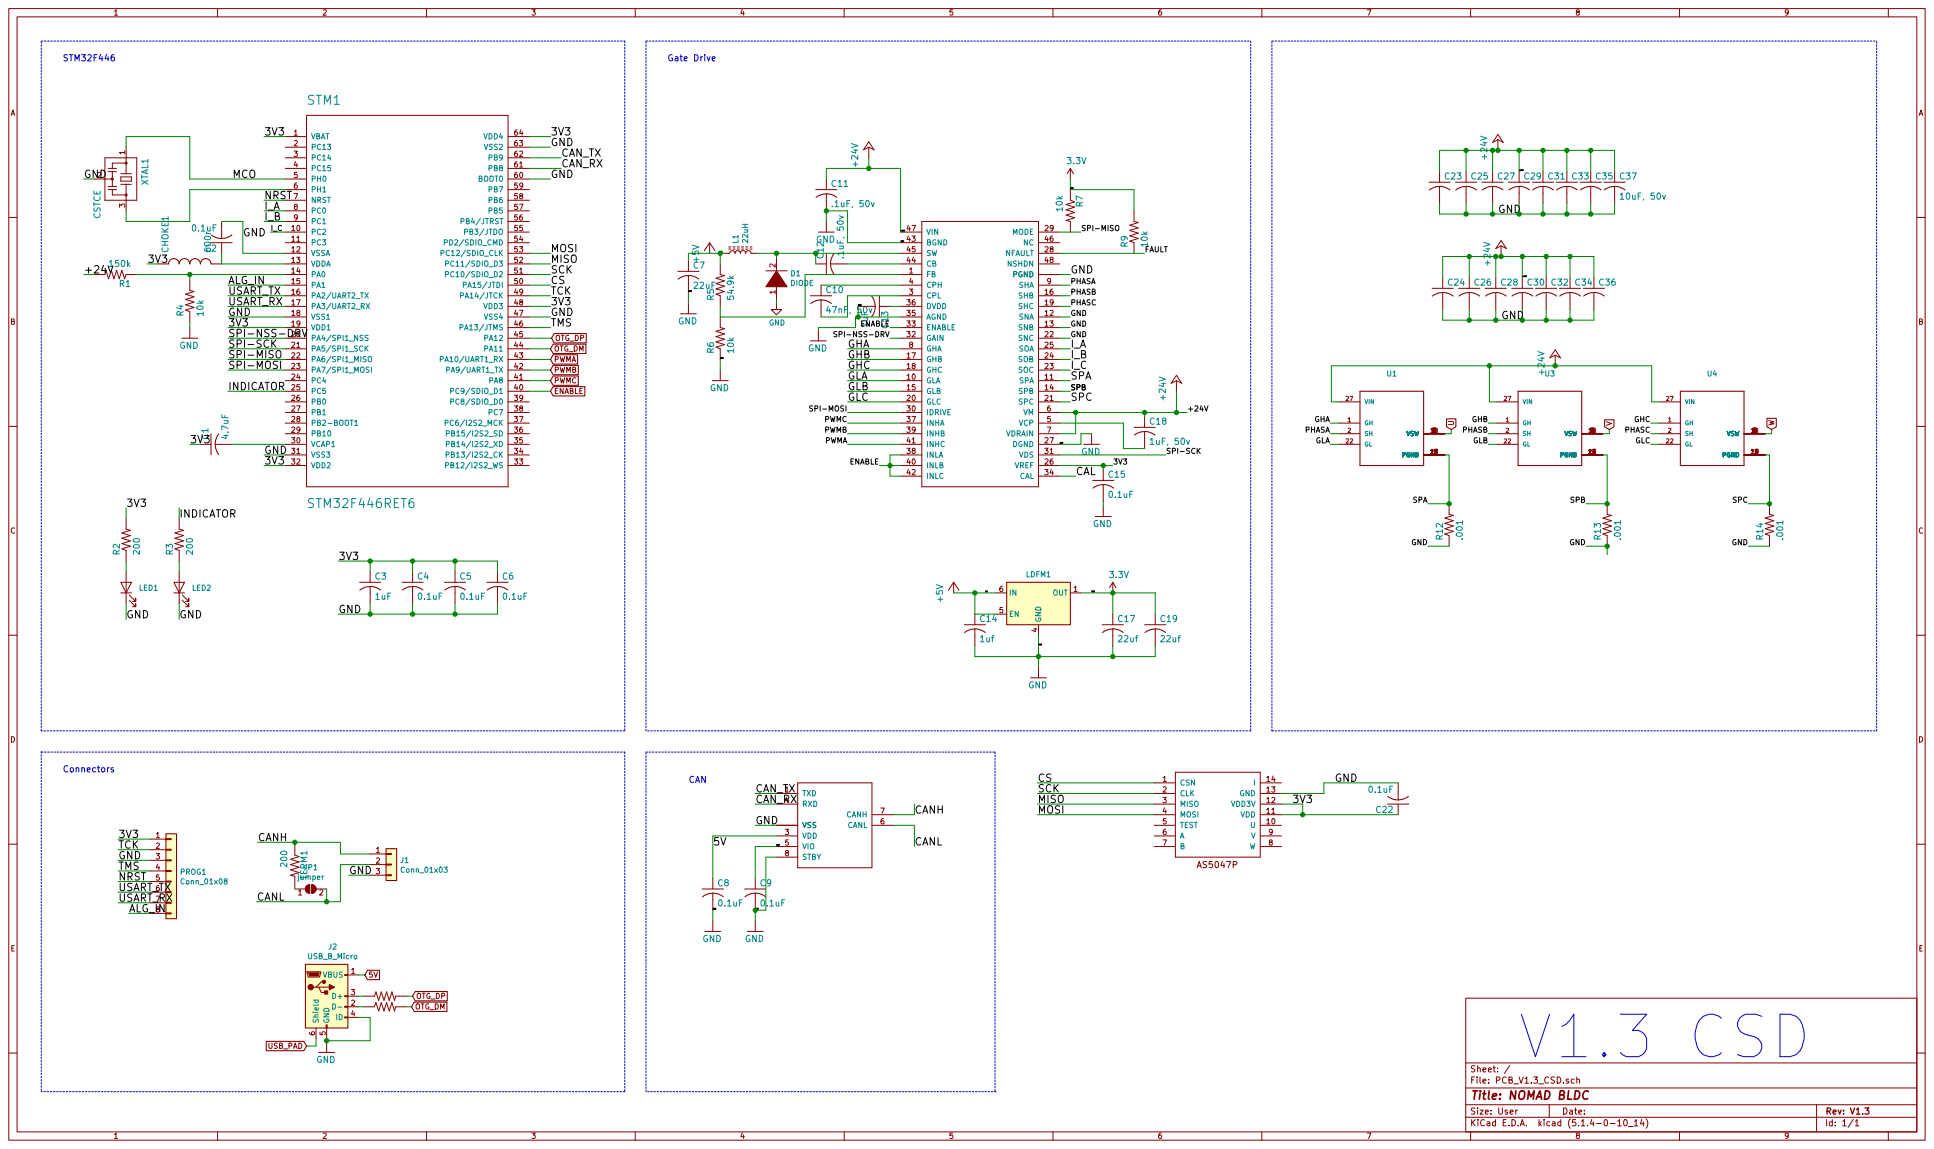
[picture p21: page 1]

SPI-MISO

SPI-MOSI
INDICATOR

File: PCB_V1.3_CSD.sch Sheet: /
Id: 1/1 Title: NOMAD BLDC
