implementedrobotics/Nomad/Hardware/Actuator/NomadBLDC/PCB_V1.2/PDFs/components.pdf

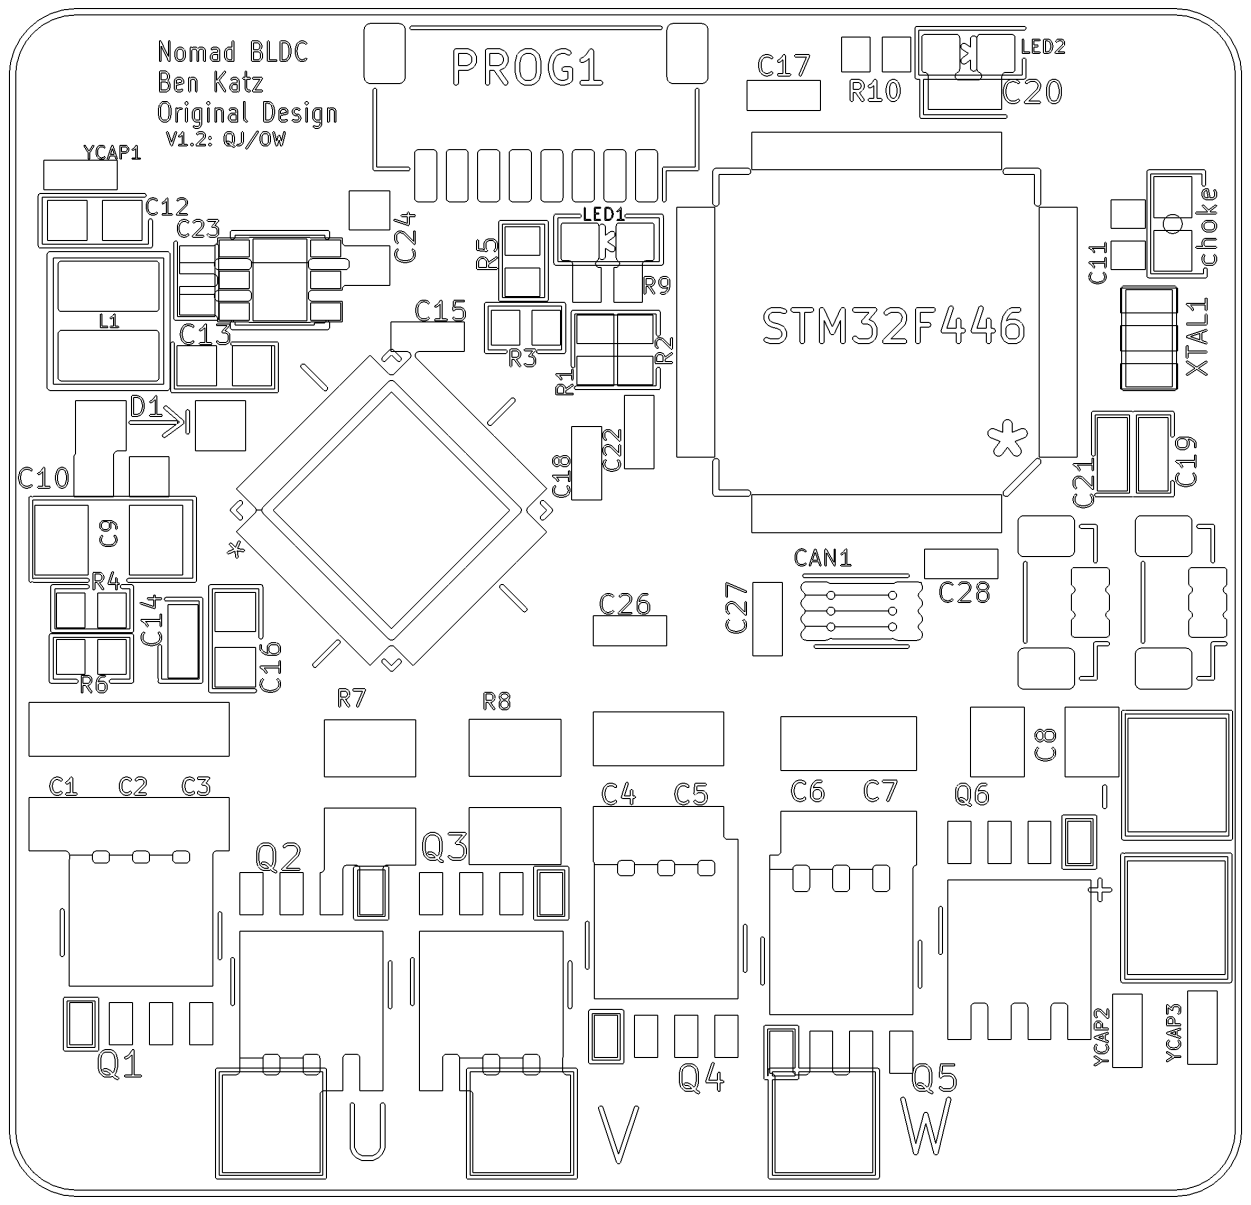
[picture p22: page 1]
