implementedrobotics/Nomad/Hardware/Actuator/NomadBLDC/PCB_V1.2/PDFs/PCB_V1.2.pdf

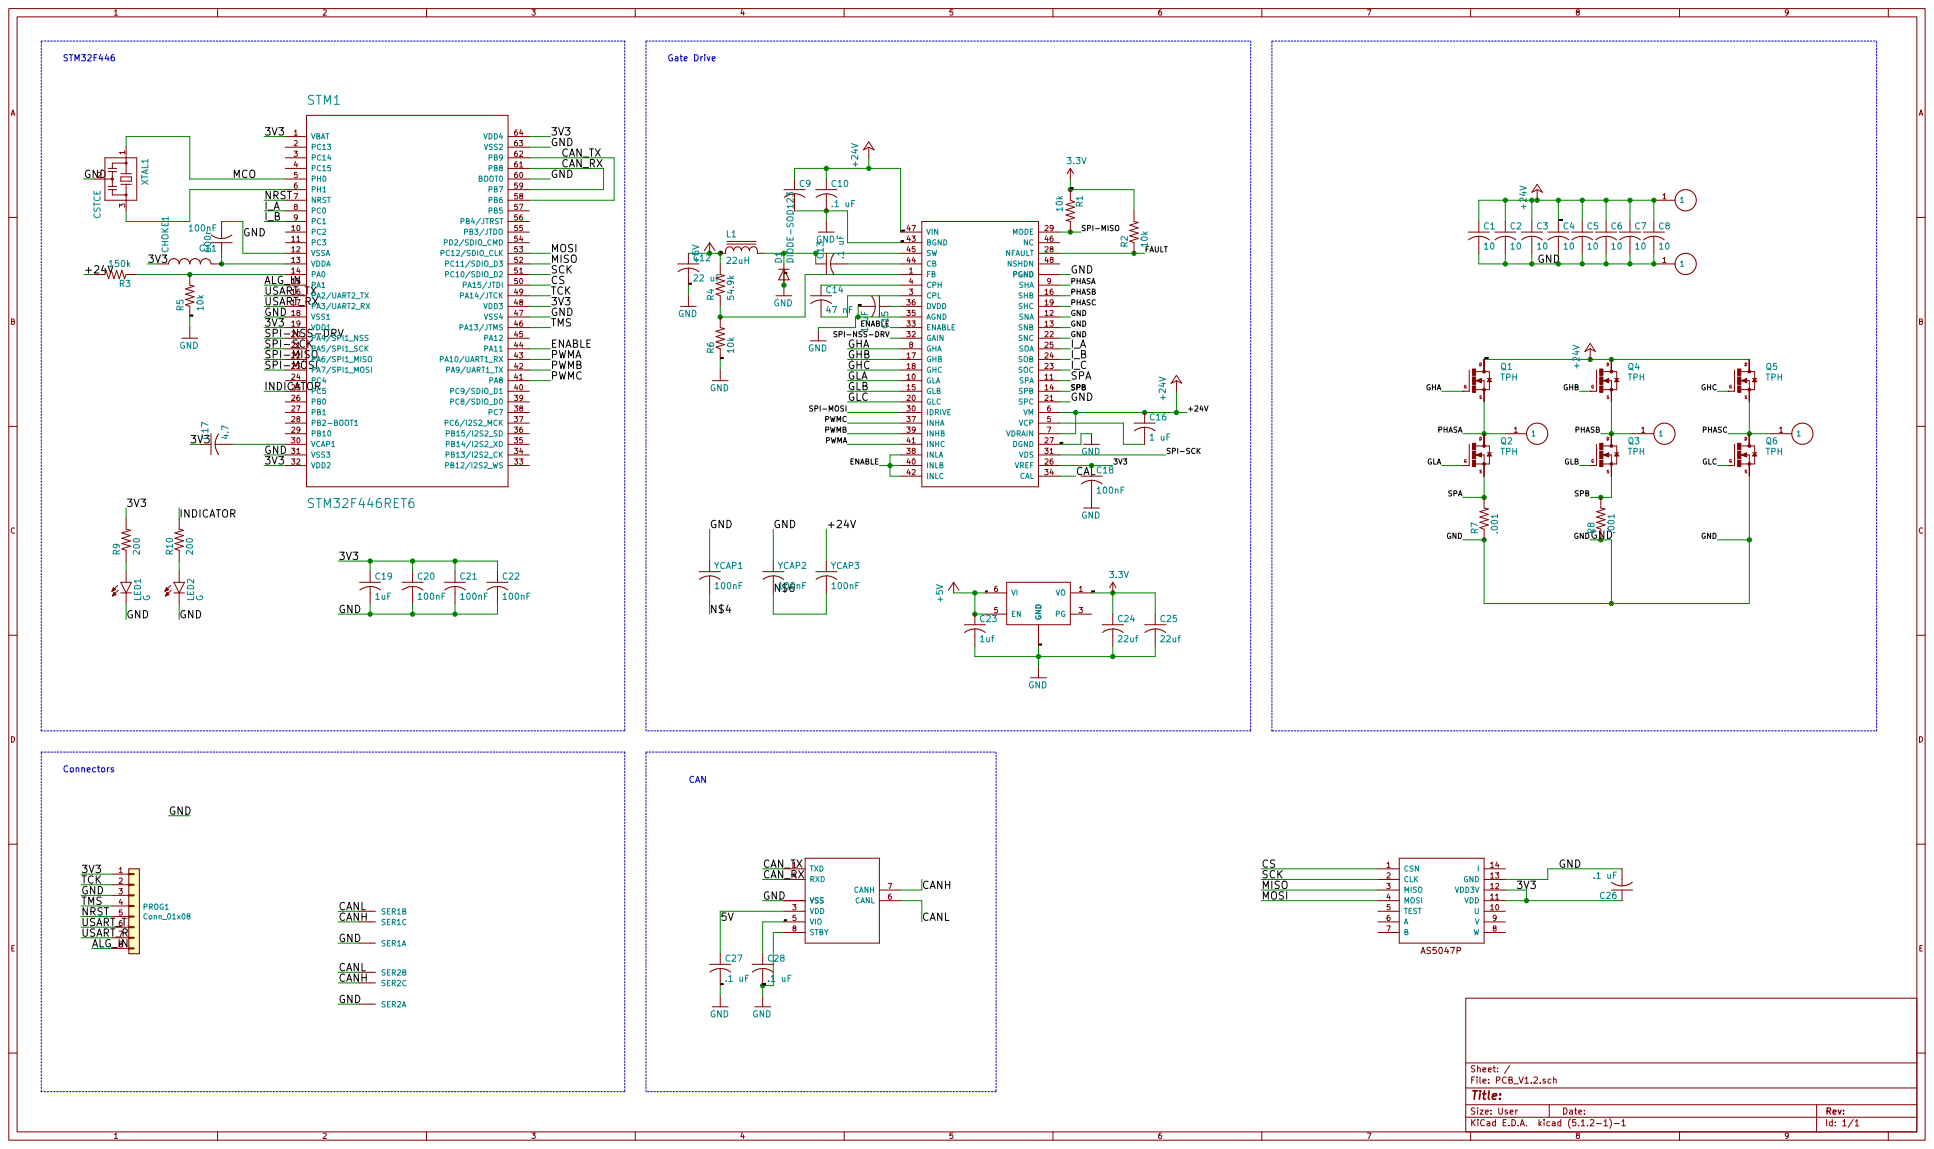
[picture p23: page 1]
