implementedrobotics/Nomad/Hardware/Actuator/NomadBLDC/PCBV1.3_CSD/KICAD/PCB_V1.3.kicad_pcb

## KiCad design Hardware/Actuator/NomadBLDC/PCBV1.3_CSD/KICAD/PCB_V1.3.kicad_pcb (2019-10-13)

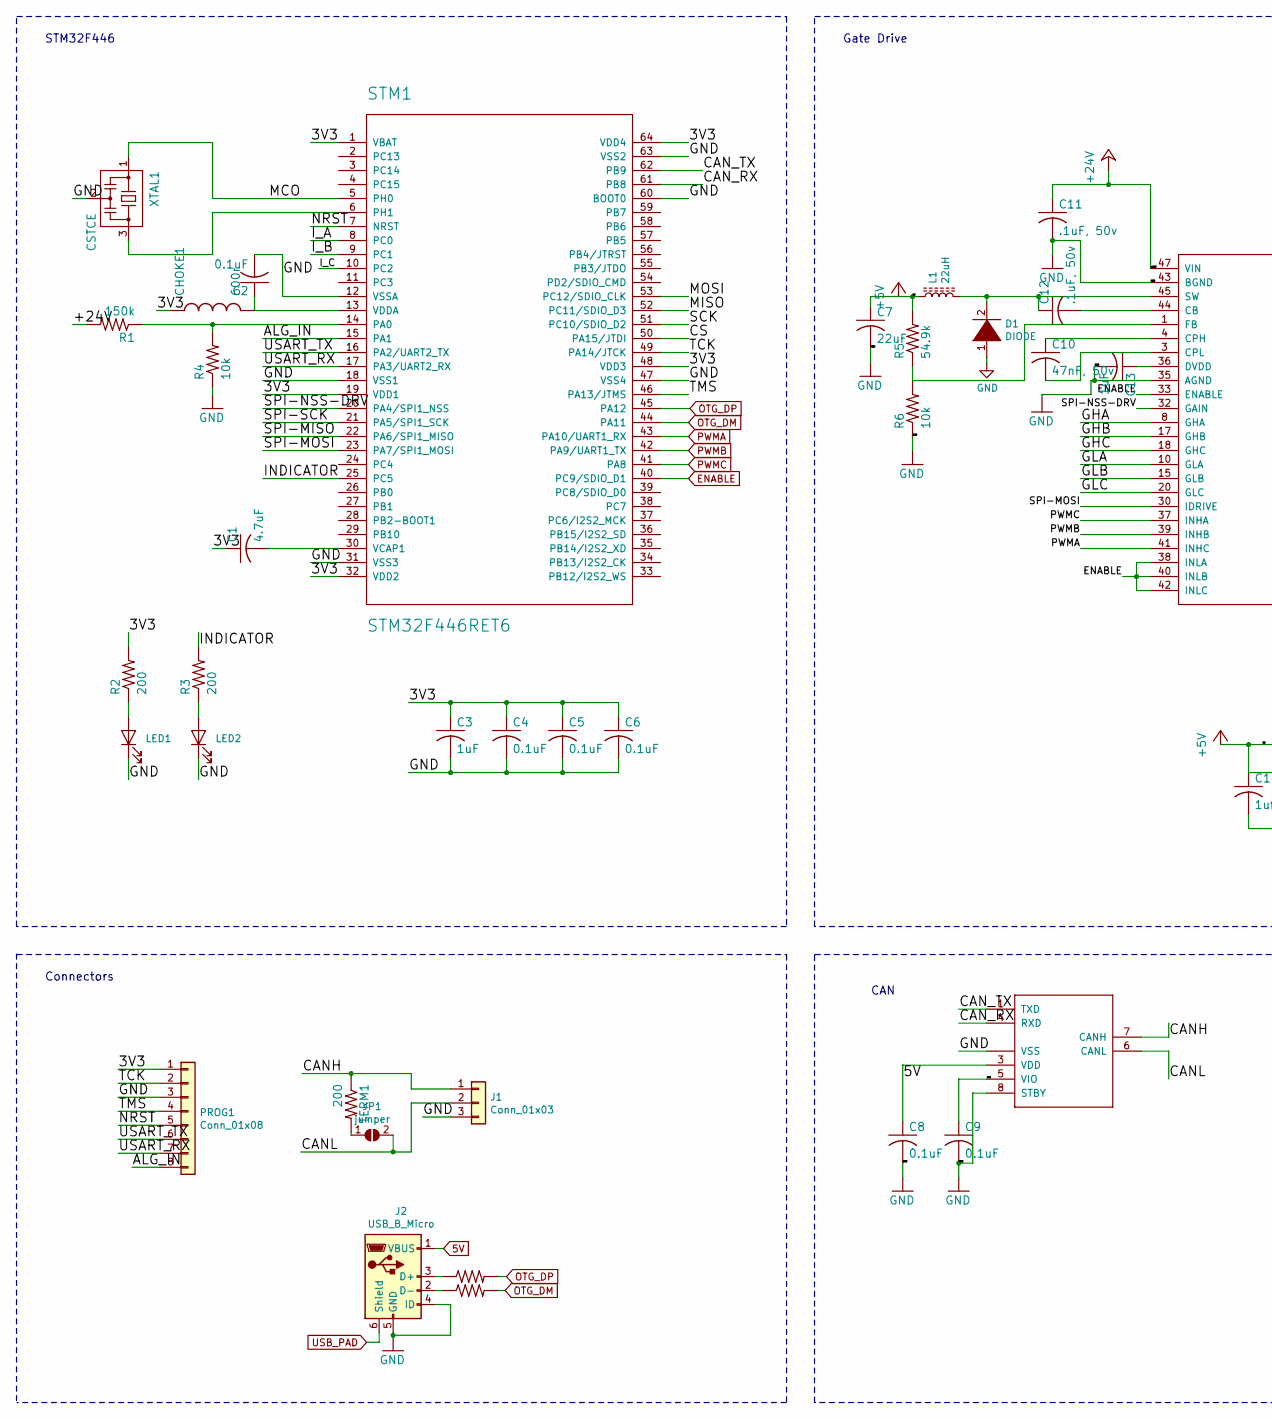
[picture p24: schematic PCB_V1.3.sch, NOMAD BLDC, part in row 1, column 1]

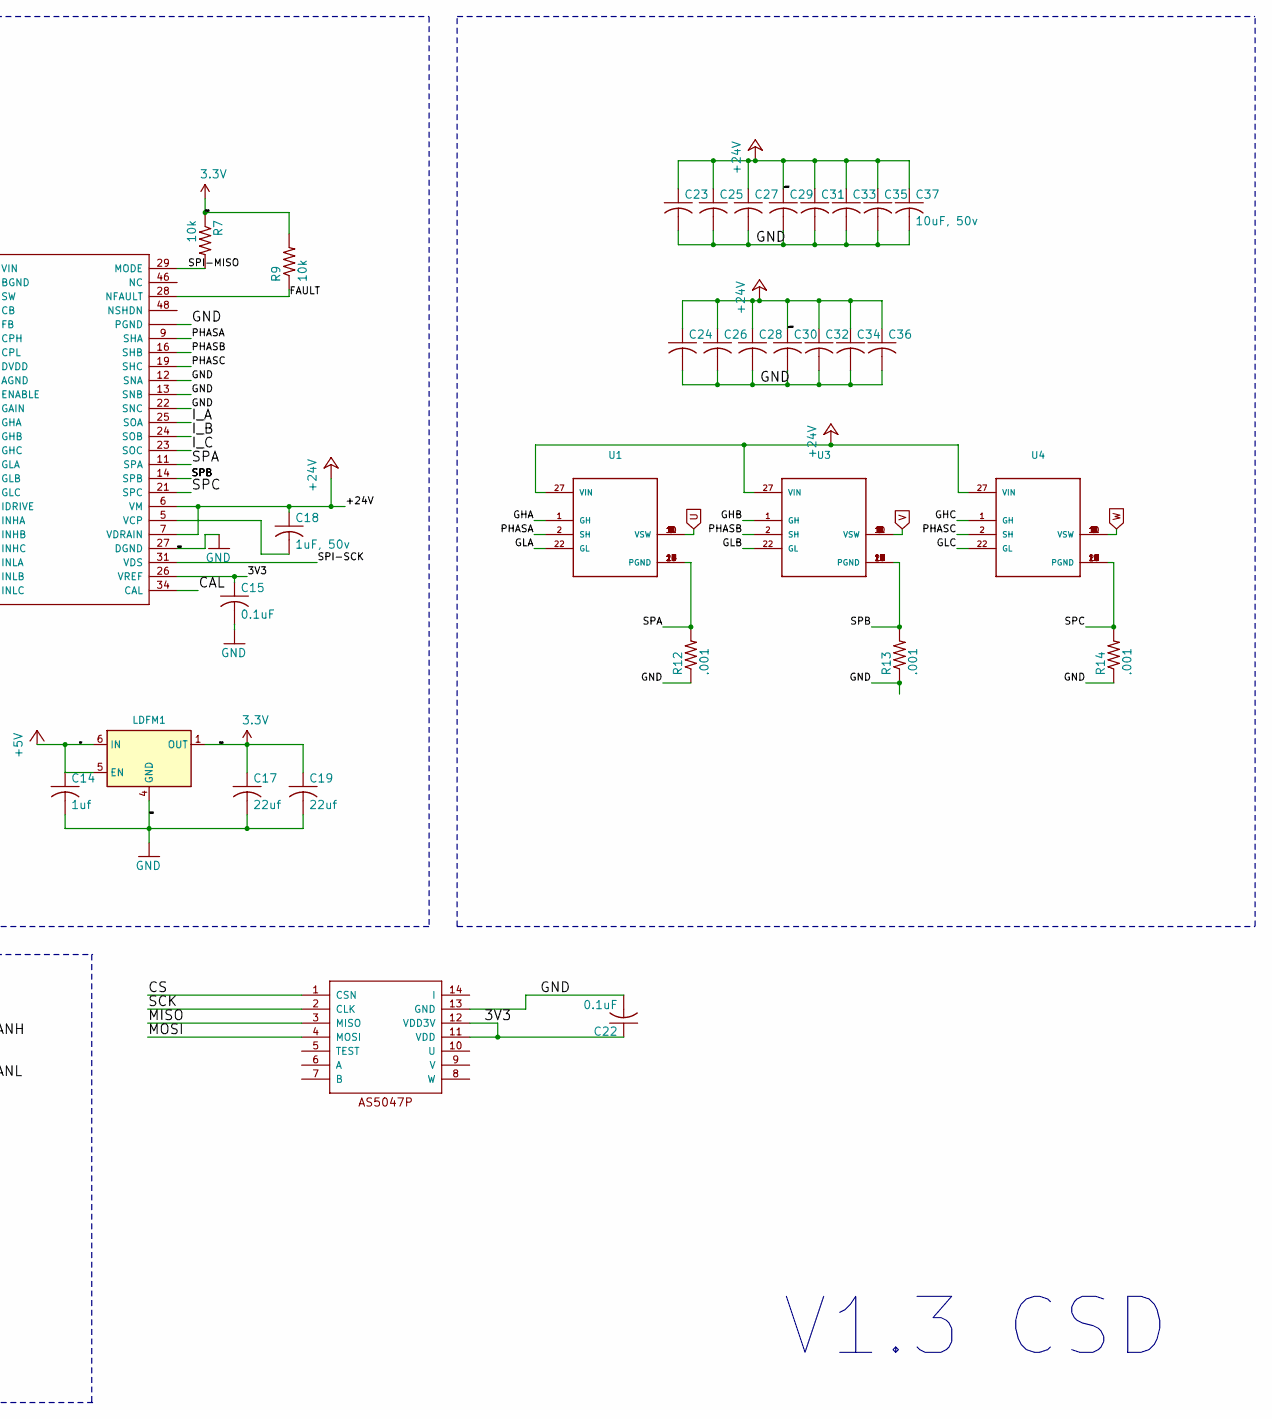
[picture p25: schematic PCB_V1.3.sch, NOMAD BLDC, part in row 1, column 2]

Parts:
AS5047P1: AS5047P; TSSOP14; MPN AS5147P-HTSM
C1: 4.7uF; C_0402_1005Metric; MPN GRM155R60J475ME87D
C2, C4, C5, C6, C8, C9, C15, C22: 0.1uF; C_0402_1005Metric; MPN C0402C104K8PAC7411
C3, C13: 1uF; C_0402_1005Metric; MPN C0402C105K8PACTU
C7: 22uF; C_0603_1608Metric; MPN GRM188R61A226ME15J
C10: 47nF, 50v; C_0402_1005Metric; MPN CC0402JRX7R9BB473
C11, C12: .1uF, 50v; C_0603_1608Metric; MPN CC0603JRX7R9BB104
C14: 1uf; C_0402_1005Metric; MPN C0402C105K8PACTU
C17, C19: 22uf; C_0603_1608Metric; MPN GRM188R61A226ME15J
C18: 1uF, 50v; C_0603_1608Metric; MPN CGA3E3X5R1H105K080AB
C23, C24, C25, C26, C27, C28, C29, C30, C31, C32, C33, C34, C35, C36, C37: 10uF, 50v; C_1206_3216Metric; MPN GRT31CR61H106ME01L
CAN1: MCP2542; TDFN-8-1EP_3x2mm_P0.5mm_EP1.80x1.65mm; MPN MCP2542FDT-H/MNY
CHOKE1: 600r; L_0603_1608Metric; MPN PE-0603FB601ST
D1: DIODE; D_SOD-123; MPN MBR0580S1-7
DRV1: DRV8323RH; Texas_S-PVQFN-N48_EP5.15x5.15mm_Islands; MPN DRV8323RSRGZT
J1: Conn_01x03; JST_SH_BM03B-SRSS-TB_1x03-1MP_P1.00mm_Vertical; MPN BM03B-SURS-TF(LF)(SN)
J2: USB_B_Micro; USB_Micro-B_GCT_USB3076-30-A; MPN USB3076-30-A
JP1: jumper; SolderJumper-2_P1.3mm_Open_RoundedPad1.0x1.5mm
L1: 22uH; SDR0302; MPN NRH3012T220MNV
LDFM1: LDFM; DFN-6-1EP_3x3mm_P1mm_EP1.5x2.4mm; MPN LDFM33PUR
LED1, LED2: LED; LED_0603_1608Metric; MPN LTST-C191KRKT
PROG1: Conn_01x08; JST_SH_SM08B-SRSS-TB_1x08-1MP_P1.00mm_Horizontal; MPN SM08B-SRSS-TB(LF)(SN)
R1: 150k; R_0402_1005Metric; MPN RC0402DR-07150KL
R2, R3: 200; R_0402_1005Metric; MPN RC0402JR-07200RL
R4, R6, R7, R9: 10k; R_0402_1005Metric; MPN RT0402DRE0710KL
R5: 54.9k; R_0402_1005Metric; MPN RC0402FR-0754K9L
R8, R10: 22; R_0402_1005Metric; MPN RC0402JR-0722RL
R12, R13, R14: .001; R_1210_3225Metric; MPN PMR25HZPFV1L00
STM1: STM32F446RET6; TQFP-64_10x10mm_P0.5mm; MPN STM32F446RET6
TERM1: 200; R_0402_1005Metric; MPN RC0402JR-07200RL
U1, U3, U4: CSD88599Q5DC; MOSFET_CSD88599Q5DC; MPN CSD88599Q5DC
XTAL1: CSTCE; MPN CSTNE8M00GH5L000R0

Connections:
3.3V: AS5047P1.11 (VDD), AS5047P1.12 (VDD3V), C1.1, C3.1, C4.1, C5.1, C6.1, C9.1, C15.1, C17.1, C19.1, C22.1, CAN1.5 (VIO), CHOKE1.1, DRV1.26 (VREF), LDFM1.1 (OUT), PROG1.1, R2.2, R7.1, R9.2, STM1.1 (VBAT), STM1.19 (VDD1), STM1.32 (VDD2), STM1.48 (VDD3), STM1.64 (VDD4)
5V: C7.1, C8.1, C14.1, CAN1.3 (VDD), J2.1 (VBUS), L1.1, LDFM1.5 (EN), LDFM1.6 (IN), R5.2
+24V: C11.1, C18.1, C23.1, C24.1, C25.1, C26.1, C27.1, C28.1, C29.1, C30.1, C31.1, C32.1, C33.1, C34.1, C35.1, C36.1, C37.1, DRV1.6 (VM), DRV1.7 (VDRAIN), DRV1.47 (VIN), R1.2, U1.27 (VIN), U3.27 (VIN), U4.27 (VIN)
/ALG_IN: PROG1.8, STM1.15 (PA1)
/CAL: DRV1.34 (CAL)
/CANH: CAN1.7 (CANH), J1.1, TERM1.1
/CANL: CAN1.6 (CANL), J1.2, JP1.2 (B)
/CAN_RX: CAN1.4 (RXD), STM1.61 (PB8)
/CAN_TX: CAN1.1 (TXD), STM1.62 (PB9)
/CS: AS5047P1.1 (CSN), STM1.50 (PA15/JTDI)
/FAULT: DRV1.28 (NFAULT), R9.1
/GHA: DRV1.8 (GHA), U1.1 (GH)
/GHB: DRV1.17 (GHB), U3.1 (GH)
/GHC: DRV1.18 (GHC), U4.1 (GH)
/GLA: DRV1.10 (GLA), U1.22 (GL)
/GLB: DRV1.15 (GLB), U3.22 (GL)
/GLC: DRV1.20 (GLC), U4.22 (GL)
/INDICATOR: R3.2, STM1.25 (PC5)
/I_A: DRV1.25 (SOA), STM1.8 (PC0)
/I_B: DRV1.24 (SOB), STM1.9 (PC1)
/I_C: DRV1.23 (SOC), STM1.10 (PC2)
/MCO: STM1.5 (PH0), XTAL1.1
/MISO: AS5047P1.3 (MISO), STM1.52 (PC11/SDIO_D3)
/MOSI: AS5047P1.4 (MOSI), STM1.53 (PC12/SDIO_CLK)
/NRST: PROG1.5, STM1.7 (NRST)
/PHASA: DRV1.9 (SHA), U1.2 (SH)
/PHASB: DRV1.16 (SHB), U3.2 (SH)
/PHASC: DRV1.19 (SHC), U4.2 (SH)
/SCK: AS5047P1.2 (CLK), STM1.51 (PC10/SDIO_D2)
/SPA: DRV1.11 (SPA), R12.2, U1.12 (PGND), U1.13 (PGND), U1.14 (PGND), U1.15 (PGND), U1.16 (PGND), U1.17 (PGND), U1.18 (PGND), U1.19 (PGND), U1.20 (PGND)
/SPB: DRV1.14 (SPB), R13.2, U3.12 (PGND), U3.13 (PGND), U3.14 (PGND), U3.15 (PGND), U3.16 (PGND), U3.17 (PGND), U3.18 (PGND), U3.19 (PGND), U3.20 (PGND)
/SPC: DRV1.21 (SPC), R14.2, U4.12 (PGND), U4.13 (PGND), U4.14 (PGND), U4.15 (PGND), U4.16 (PGND), U4.17 (PGND), U4.18 (PGND), U4.19 (PGND), U4.20 (PGND)
/SPI-MISO: DRV1.29 (MODE), R7.2, STM1.22 (PA6/SPI1_MISO)
/SPI-MOSI: DRV1.30 (IDRIVE), STM1.23 (PA7/SPI1_MOSI)
/SPI-NSS-DRV: DRV1.32 (GAIN), STM1.20 (PA4/SPI1_NSS)
/SPI-SCK: DRV1.31 (VDS), STM1.21 (PA5/SPI1_SCK)
/TCK: PROG1.2, STM1.49 (PA14/JTCK)
/TMS: PROG1.4, STM1.46 (PA13/JTMS)
/USART_RX: PROG1.7, STM1.17 (PA3/UART2_RX)
/USART_TX: PROG1.6, STM1.16 (PA2/UART2_TX)
ENABLE: DRV1.33 (ENABLE), DRV1.38 (INLA), DRV1.40 (INLB), DRV1.42 (INLC), STM1.40 (PC9/SDIO_D1)
GND: AS5047P1.13 (GND), C2.2, C3.2, C4.2, C5.2, C6.2, C7.2, C8.2, C9.2, C11.2, C13.2, C14.2, C15.2, C17.2, C19.2, C22.2, C23.2, C24.2, C25.2, C26.2, C27.2, C28.2, C29.2, C30.2, C31.2, C32.2, C33.2, C34.2, C35.2, C36.2, C37.2, CAN1.2 (VSS), CAN1.8 (STBY), CAN1.9 (VSS), D1.1 (K), DRV1.2 (PGND), DRV1.12 (SNA), DRV1.13 (SNB), DRV1.22 (SNC), DRV1.27 (DGND), DRV1.35 (AGND), DRV1.43 (BGND), DRV1.49 (PGND), J1.3, J2.4 (ID), J2.5 (GND), LDFM1.4 (GND), LED1.1 (K), LED2.1 (K), PROG1.3, R4.1, R6.1, R12.1, R13.1, R14.1, STM1.12 (VSSA), STM1.18 (VSS1), STM1.31 (VSS3), STM1.47 (VSS4), STM1.60 (BOOT0), STM1.63 (VSS2), XTAL1.2
unnamed: C1.2, STM1.30 (VCAP1)
unnamed: C2.1, CHOKE1.2, STM1.13 (VDDA)
unnamed: C10.1, DRV1.4 (CPH)
unnamed: C10.2, DRV1.3 (CPL)
unnamed: C12.1, D1.2 (A), DRV1.45 (SW), L1.2
unnamed: C12.2, DRV1.44 (CB)
unnamed: C13.1, DRV1.36 (DVDD)
unnamed: C18.2, DRV1.5 (VCP)
unnamed: DRV1.1 (FB), R5.1, R6.2
unnamed: J2.2 (D-), R8.1
unnamed: J2.3 (D+), R10.1
unnamed: JP1.1 (A), TERM1.2
unnamed: LED1.2 (A), R2.1
unnamed: LED2.2 (A), R3.1
unnamed: R1.1, R4.2, STM1.14 (PA0)
unnamed: STM1.6 (PH1), XTAL1.3
OTG_DM: R8.2, STM1.44 (PA11)
OTG_DP: R10.2, STM1.45 (PA12)
PWMA: DRV1.41 (INHC), STM1.43 (PA10/UART1_RX)
PWMB: DRV1.39 (INHB), STM1.42 (PA9/UART1_TX)
PWMC: DRV1.37 (INHA), STM1.41 (PA8)
U: U1.3 (VSW), U1.4 (VSW), U1.5 (VSW), U1.6 (VSW), U1.7 (VSW), U1.8 (VSW), U1.9 (VSW), U1.10 (VSW), U1.11 (VSW)
USB_PAD: J2.6 (Shield)
V: U3.3 (VSW), U3.4 (VSW), U3.5 (VSW), U3.6 (VSW), U3.7 (VSW), U3.8 (VSW), U3.9 (VSW), U3.10 (VSW), U3.11 (VSW)
W: U4.3 (VSW), U4.4 (VSW), U4.5 (VSW), U4.6 (VSW), U4.7 (VSW), U4.8 (VSW), U4.9 (VSW), U4.10 (VSW), U4.11 (VSW)

Notes on the sheet:
Gate Drive
STM32F446
CAN
Connectors
V1.3 CSD

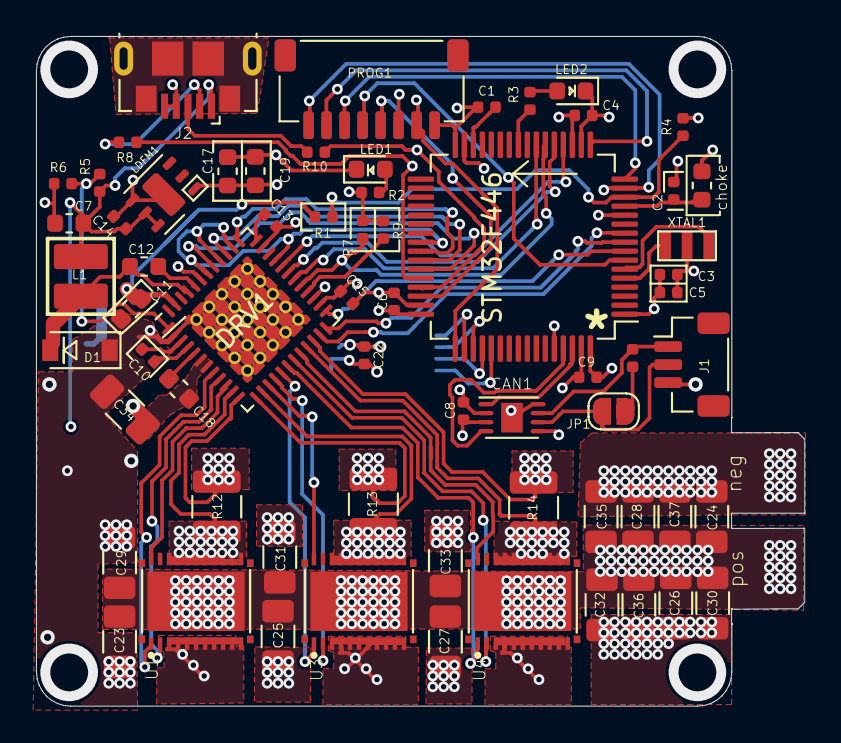
[picture p26: board PCB_V1.3.kicad_pcb from above]

Board: 4 copper layers, 42.7 x 37.2 mm, 66 parts (0 on the bottom side), 65 nets.
