implementedrobotics/Nomad/Hardware/Actuator/NomadBLDC/PCB_V1.2/kicad/PCB_V1.2/PCB_V1.2.kicad_pcb

## KiCad design Hardware/Actuator/NomadBLDC/PCB_V1.2/kicad/PCB_V1.2/PCB_V1.2.kicad_pcb (2019-10-11)

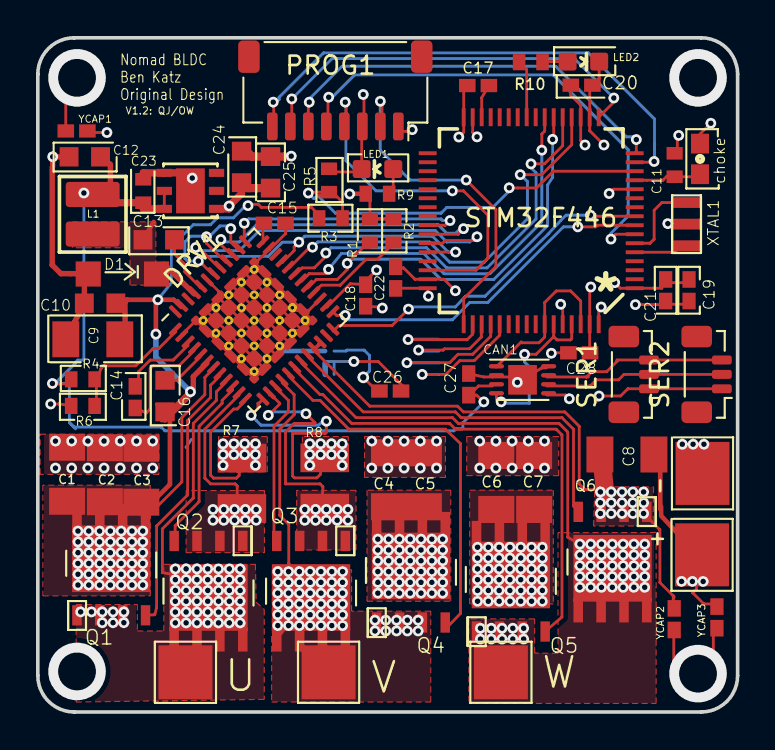
[picture p27: board PCB_V1.2.kicad_pcb from above]

Board: 4 copper layers, 38.9 x 37.5 mm, 66 parts (0 on the bottom side), 56 nets.

Parts:
AS5047P1: AS5047P; TSSOP14
C1, C2, C3, C4, C5, C6, C7, C8, C9: 10uF, 50v; C1206K
C10, C13: 0.1uF, 50v; C0603K
C11: 100nF; C0402
C12: 22uF; C0603K
C14: 47nF, 50v; C0402K
C15, C19: 1uF; C0402K
C16: 1uF, 50v; C0603K
C17: 4.7uF; C0402K
C18, C20, C21, C22: 100nF; C0402K
C23: 1uf; C0402
C24, C25: 22uf; C0603K
C26, C27, C28: .1uF; C0402K
CAN1: MCP2542; TDFN-8-1EP_3x2mm_P0.5mm_EP1.80x1.65mm
CHOKE1: 600r; 0603
D1: DIODE-SOD123; SOD123
DRV1: DRV8323RH; Texas_S-PVQFN-N48_EP5.15x5.15mm_Islands
L1: 22uH; SDR0302
LDFM1: LDFM; DFN6-3X3
LED1, LED2: G; LED-0603
PROG1: Conn_01x08; JST_SH_SM08B-SRSS-TB_1x08-1MP_P1.00mm_Horizontal
Q1, Q2, Q3, Q4, Q5, Q6: TPH; TRANS_TPH5900CNH,L1Q
R1, R2, R5, R6: 10k; R0402
R3: 150k; R0402
R4: 54.9k; R0402
R7, R8: .001; R1210
R9, R10: 200; R0402
SER1, SER2: ?M03B-SRSS-TBS; JST_SUR_BM03B-SURS-TF_1x03-1MP_P0.80mm_Vertical
STM1: STM32F446RET6; TQFP64
U$1, U$2: 18_AWG_PAD; TestPoint_Pad_3.0x3.5mm
U$3: test_point; TestPoint_Pad_3.0x3.0mm
U$4, U$5: 18_AWG_PAD; TestPoint_Pad_3.0x3.0mm
XTAL1: CSTCE
YCAP1, YCAP2, YCAP3: 100nF; C0402K

Connections:
3.3V: AS5047P1.11, AS5047P1.12, C17.1, C18.1, C19.1, C20.1, C21.1, C22.1, C24.1, C25.1, C26.1, C28.1, CAN1.5, CHOKE1.1, DRV1.26, LDFM1.1, PROG1.1, R1.1, R2.2, R9.2, STM1.1, STM1.19, STM1.32, STM1.48, STM1.64
+5V: C12.1, C23.1, C27.1, CAN1.3, L1.1, LDFM1.5, LDFM1.6, R4.2
+24V: C1.1, C2.1, C3.1, C4.1, C5.1, C6.1, C7.1, C8.1, C9.1, C10.1, C16.1, DRV1.6, DRV1.7, DRV1.47, Q1.5, Q1.6, Q1.7, Q1.8, Q1.EP, Q4.5, Q4.6, Q4.7, Q4.8, Q4.EP, Q5.5, Q5.6, Q5.7, Q5.8, Q5.EP, R3.2, U$1.1, YCAP3.1
/ALG_IN: PROG1.8, STM1.15
/CANH: CAN1.7, SER1.3, SER2.3
/CANL: CAN1.6, SER1.2, SER2.2
/CAN_RX: CAN1.4, STM1.59, STM1.61
/CAN_TX: CAN1.1, STM1.58, STM1.62
/CS: AS5047P1.1, STM1.50
/ENABLE: DRV1.33, DRV1.38, DRV1.40, DRV1.42, STM1.44
/FAULT: DRV1.28, R2.1
/GHA: DRV1.8, Q1.4
/GHB: DRV1.17, Q4.4
/GHC: DRV1.18, Q5.4
/GLA: DRV1.10, Q2.4
/GLB: DRV1.15, Q3.4
/GLC: DRV1.20, Q6.4
/INDICATOR: R10.2, STM1.25
/I_A: DRV1.25, STM1.8
/I_B: DRV1.24, STM1.9
/MCO: STM1.5, XTAL1.1
/MISO: AS5047P1.3, STM1.52
/MOSI: AS5047P1.4, STM1.53
/N$6: YCAP2.2, YCAP3.2
/NRST: PROG1.5, STM1.7
/PHASA: DRV1.9, Q1.1, Q1.2, Q1.3, Q2.5, Q2.6, Q2.7, Q2.8, Q2.EP, U$3.1
/PHASB: DRV1.16, Q3.5, Q3.6, Q3.7, Q3.8, Q3.EP, Q4.1, Q4.2, Q4.3, U$4.1
/PHASC: DRV1.19, Q5.1, Q5.2, Q5.3, Q6.5, Q6.6, Q6.7, Q6.8, Q6.EP, U$5.1
/PWMA: DRV1.41, STM1.43
/PWMB: DRV1.39, STM1.42
/PWMC: DRV1.37, STM1.41
/SCK: AS5047P1.2, STM1.51
/SPA: DRV1.11, Q2.1, Q2.2, Q2.3, R7.2
/SPB: DRV1.14, Q3.1, Q3.2, Q3.3, R8.2
/SPI-MISO: DRV1.29, R1.2, STM1.22
/SPI-MOSI: DRV1.30, STM1.23
/SPI-NSS-DRV: DRV1.32, STM1.20
/SPI-SCK: DRV1.31, STM1.21
/TCK: PROG1.2, STM1.49
/TMS: PROG1.4, STM1.46
/USART_RX: PROG1.7, STM1.17
/USART_TX: PROG1.6, STM1.16
GND: AS5047P1.13, C1.2, C2.2, C3.2, C4.2, C5.2, C6.2, C7.2, C8.2, C9.2, C10.2, C11.2, C12.2, C15.2, C18.2, C19.2, C20.2, C21.2, C22.2, C23.2, C24.2, C25.2, C26.2, C27.2, C28.2, CAN1.2, CAN1.8, CAN1.9, D1.A, DRV1.2, DRV1.12, DRV1.13, DRV1.21, DRV1.22, DRV1.27, DRV1.35, DRV1.43, DRV1.49, LDFM1.4, LDFM1.EXP, LED1.C, LED2.C, PROG1.3, Q6.1, Q6.2, Q6.3, R5.1, R6.1, R7.1, R8.1, SER1.1, SER2.1, STM1.12, STM1.18, STM1.31, STM1.47, STM1.60, STM1.63, U$2.1, XTAL1.2, YCAP1.1, YCAP2.1
unnamed: C11.1, CHOKE1.2, STM1.13
unnamed: C13.1, D1.C, DRV1.45, L1.2
unnamed: C13.2, DRV1.44
unnamed: C14.1, DRV1.4
unnamed: C14.2, DRV1.3
unnamed: C15.1, DRV1.36
unnamed: C16.2, DRV1.5
unnamed: C17.2, STM1.30
unnamed: DRV1.1, R4.1, R6.2
unnamed: LED1.A, R9.1
unnamed: LED2.A, R10.1
unnamed: R3.1, R5.2, STM1.14
unnamed: STM1.6, XTAL1.3
