implementedrobotics/Nomad/Hardware/Actuator/NomadBLDC/FirmwareG4/FirmwareG4.ioc

Mcu.UserName=STM32G474CEUx
PA0.GPIO_Label=ENC_A
PA0.Signal=S_TIM2_CH1
PA1.GPIO_Label=ENC_B
PA1.Signal=S_TIM2_CH2
PA10.GPIO_Label=DRV_MISO
PA10.Signal=SPI2_MISO
PA13.GPIO_Label=TMS
PA13.Signal=SYS_JTMS-SWDIO
PA14.GPIO_Label=TCK
PA14.Signal=SYS_JTCK-SWCLK
PA15.GPIO_Label=DRV_nFAULT
PA15.Signal=GPIO_Input
PA2.GPIO_Label=USART_TX
PA2.Signal=USART2_TX
PA3.GPIO_Label=USART_RX
PA3.Signal=USART2_RX
PA4.GPIO_Label=ENC_CS
PA4.Signal=GPIO_Output
PA5.GPIO_Label=ENC_SCK
PA5.Signal=SPI1_SCK
PA6.GPIO_Label=ENC_MISO
PA6.Signal=SPI1_MISO
PA7.GPIO_Label=ENC_MOSI
PA7.Signal=SPI1_MOSI
PA8.GPIO_Label=EXT_TEMP
PA8.Signal=ADC5_IN1
PA9.GPIO_Label=BATT_IN
PA9.Signal=ADC5_IN2
PB0.GPIO_Label=I_B
PB0.Signal=ADC3_IN12
PB1.GPIO_Label=I_C
PB1.Signal=ADC1_IN12
PB10.GPIO_Label=LED_STATUS
PB10.Signal=GPIO_Output
PB12.GPIO_Label=DRV_CS
PB12.Signal=GPIO_Output
PB13.GPIO_Label=DRV_SCK
PB13.Signal=SPI2_SCK
PB14.GPIO_Label=FET_TEMP
PB14.Signal=ADC4_IN4
PB15.GPIO_Label=DRV_MOSI
PB15.Signal=SPI2_MOSI
PB3.GPIO_Label=CAN_RX
PB3.Signal=FDCAN3_RX
PB4.GPIO_Label=CAN_TX
PB4.Signal=FDCAN3_TX
PB5.GPIO_Label=DRV_ENABLE
PB5.Signal=GPIO_Output
PB6.GPIO_Label=PWM_A
PB6.Signal=S_TIM8_CH1
PB8-BOOT0.GPIO_Label=PWM_B
PB8-BOOT0.Signal=S_TIM8_CH2
PB9.GPIO_Label=PWM_C
PB9.Signal=S_TIM8_CH3
PC4.GPIO_Label=I_A
PC4.Signal=ADC2_IN5
PC6.GPIO_Label=USER_GPIO
PC6.Signal=GPIO_Output
PF0-OSC_IN.Signal=RCC_OSC_IN
PF1-OSC_OUT.Signal=RCC_OSC_OUT
