implementedrobotics/Nomad/Hardware/Actuator/NomadBLDC/FirmwareG4/NomadBLDC/include/MotorController.h

/*
 * MotorController.h
 *
 *  Created on: August 25, 2019
 *      Author: Quincy Jones
 *
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
 */

#ifndef CORE_MOTOR_CONTROLLER_H_
#define CORE_MOTOR_CONTROLLER_H_

// TODO: Move from macros to c++ constexpr/configuratble variables from Tool UI
// Some Constants
#define ADC_RES 12                    // ADC Resolution (12-Bits)
#define VBUS_DIVIDER 16               // (150K+10K/10K)
#define SENSE_RESISTANCE (5e-4)       // 0.5 milliohm sense resistor
#define SENSE_CONDUCTANCE (2000)      // SENSE_RESISTANCE^-1
#define CURRENT_SENSE_GAIN 40         // Gain from current amplifier.  TODO: A Parameter

// Duty Cycle Min/Max
#define DTC_MAX 0.94f // Max phase duty cycle
#define DTC_MIN 0.0f  // Min phase duty cycle

// C System Files
#include <arm_math.h>

// C++ System Files

// Project Includes
#include "cmsis_os2.h"
#include "Motor.h"
#include "RMSCurrentLimiter.h"
#include "DRV8323.h"
#include <RegisterInterface.h>
#include <Peripherals/spi.h>
#include <Peripherals/gpio.h>
#include <Peripherals/fdcan.h>
#include <nomad_hw.h>

static const float voltage_scale = 3.3f * VBUS_DIVIDER / (float)(1 << ADC_RES);
static const float current_scale = 3.3f / (float)(1 << ADC_RES) * SENSE_CONDUCTANCE * 1.0f / CURRENT_SENSE_GAIN;

extern Motor *motor;
extern MotorController *motor_controller;

class ADCDevice;
class Thermistor;
class NomadBLDCFSM;

typedef enum : uint8_t
{
    STARTUP_MODE = 0,
    IDLE_MODE = 1,
    ERROR_MODE = 2,
    MEASURE_RESISTANCE_MODE = 3,
    MEASURE_INDUCTANCE_MODE = 4,
    MEASURE_PHASE_ORDER_MODE = 5,
    MEASURE_ENCODER_OFFSET_MODE = 6,
    CALIBRATION_MODE = 7,
    POSITION_MODE = 8,
    VELOCITY_MODE = 9,
    PD_MODE = 10,
    TORQUE_MODE = 11,
    CURRENT_MODE = 12,
    VOLTAGE_MODE = 13
} control_mode_type_t;

typedef enum
{
    SUCCESSFUL = 0,
    FOC_TIMING_ERROR = 1,
    OVERVOLTAGE_ERROR = 2,
    UNDERVOLTAGE_ERROR = 3,
    OVERTEMPERATURE_ERROR = 4,
    NOT_CALIBRATED_ERROR = 5,
    MEASUREMENT_OUT_OF_RANGE = 6,
    MEASUREMENT_TIMEOUT = 7,
    WATCHDOG_TIMEOUT = 8,
    OVERSPEED_ERROR = 9,
    POSITION_LIMIT_EXCEEDED = 10,
    TORQUE_LIMIT_EXCEEDED = 11,
    CURRENT_LIMIT_EXCEEDED = 12,
} error_type_t;

class MotorController
{
public:

    // Motor Controller Parameters
    struct Config_t
    {
        // Config Reg 1
        float k_d;               // Current Controller Loop Gain (D Axis)
        float k_q;               // Current Controller Loop Gain (Q Axis)
        float k_i_d;             // Current Controller Integrator Gain (D Axis)
        float k_i_q;             // Current Controller Integrator Gain (Q Axis)
        float k_i_vel;           // Velocity Integrator Gain
        float current_bandwidth; // Current Loop Bandwidth (200 to 2000 hz)
        float overmodulation;    // Overmodulation Amount
        float pwm_freq;          // PWM Switching Frequency
        uint32_t foc_ccl_divider; // Divider to use for FOC Current control loop frequency
        uint32_t ccr1_reserved[2]; // Reserved
        
        // Config Reg 2
        float K_p_max;           // Position Gain Maximum
        float K_d_max;           // Velocity Gain Maximum
        float K_p_limit;         // Position Limiting Mode Proportional Gain
        float K_d_limit;         // Position Limiting Mode Derivative Gain
        float pos_limit_min;     // Limit on position input max
        float pos_limit_max;     // Limit on position input min
        float velocity_limit;    // Velocity Limit
        float torque_limit;      // Torque Limit
        float current_limit;     // Max Current Limit
        uint32_t ccr2_reserved[2]; // Reserved
    };

    struct State_t
    {
        // TODO: Extra Status States?  In PositionLimit, VelocityLimit, TorqueLimit etc.
        // Current State
        float I_d;                   // Transformed Current (D Axis)
        float I_q;                   // Transformed Current (Q Axis)

        // Voltage State
        float V_d;                   // Voltage (D Axis)
        float V_q;                   // Voltage (Q Axis)

        float d_int;                 // Current Integral Error
        float q_int;                 // Current Integral Error

        // Duty Cycles
        float dtc_A;                 // Duty Cycle for A phase
        float dtc_B;                 // Duty Cycle for B phase
        float dtc_C;                 // Duty Cycle for C phase

        // RMS Limiting
        float I_rms;                 // Motor RMS Current Value
        float I_max;                 // Maximum Allowable Commanded Current in next Time Step

        // Timeouts
        uint32_t timeout;            // Keep up with number of controller timeouts for missed deadlines

        float Vel_int;      // Velocity Integrator Error
        
        // Voltage Control Setpoints
        float V_d_ref; // Voltage Reference (D Axis)
        float V_q_ref; // Voltage Reference (Q Axis)

        // Modulation Control Theta Reference
        float Theta_ref; // Rotor Angle Reference (Optional used primarily for calibration/open loop mode)

        // Current Control Setpoints
        float I_d_ref; // Current Reference (D Axis)
        float I_q_ref; // Current Reference (Q Axis)

        // Position Control Setpoints
        float Pos_ref;      // Position Setpoint Reference
        float K_p;          // Position Gain N*m/rad

        // Velocity Control Setpoints
        float Vel_ref;      // Velocity Setpoint Reference
        float K_d;          // Velocity Gain N*m/rad/s

        // Torque Feedforward Setpoint
        float T_ff;         // Feed Forward Torque Value N*m

        // TODO: Remove these when ported fully
        float Voltage_bus;
        float I_bus;
        float fet_temp;
    };

    struct Debug_t                    // Debug Struct
    {
        uint32_t control_loop_ticks;  // DWT Ticks for control loop execution
        uint32_t missed_deadlines;    // How many control deadlines have been missed
        uint32_t cpu_utilization;     // Current CPU Utlization by the uC
    };

    MotorController(Motor *motor);

    static MotorController* GetInstance() { return singleton_; } // Singleton Instance
    inline Motor* GetMotor() { return motor_; }

    void Init();            // Init Controller
    void Reset();           // Reset Controller

    void CurrentMeasurementCB() CCM_ATTRIBUTE; // Callback from ADC Current Measurement
    bool RunControlFSM() CCM_ATTRIBUTE;   // Do an FSM Step
    void StartPWM();        // Setup PWM Timers/Registers
    void StartADCs();       // Start ADC Inputs

    void SampleBusVoltage();  // Poll/Update Bus Voltage ADC value
    void SampleFETTemperature();  // Poll/Update FET Thermistor value

    // TODO: Moved to PWM Generator
    void EnablePWM(bool enable); // Enable/Disable PWM Timers
    void SetModulationOutput(float theta, float v_d, float v_q) CCM_ATTRIBUTE;  // Helper Function to compute PWM Duty Cycles directly from D/Q Voltages
    void SetModulationOutput(float v_alpha, float v_beta) CCM_ATTRIBUTE;        // Helper Function to compute PWM Duty Cycles directly from Park Inverse Transformed Alpha/Beta Voltages
    void SetDuty(float duty_A, float duty_B, float duty_C) ;       // Set PWM Duty Cycles Directly
    void SVM(float a, float b, float c, float *dtc_a, float *dtc_b, float *dtc_c) CCM_ATTRIBUTE;

    void UpdateControllerGains();                                 // Controller Gains from Measured Motor Parameters

    // TOOD: Move This outTransforms
    void dqInverseTransform(float theta, float d, float q, float *a, float *b, float *c) CCM_ATTRIBUTE; // DQ Transfrom -> A, B, C voltages
    void dq0(float theta, float a, float b, float c, float *d, float *q) CCM_ATTRIBUTE;
    
    // TODO: Move All This Out
    void ParkInverseTransform(float theta, float d, float q, float *alpha, float *beta) CCM_ATTRIBUTE;
    void ParkTransform(float theta, float alpha, float beta, float *d, float *q) CCM_ATTRIBUTE;
    void ClarkeInverseTransform(float alpha, float beta, float *a, float *b, float *c) CCM_ATTRIBUTE;
    void ClarkeTransform(float I_a, float I_b, float *alpha, float *beta) CCM_ATTRIBUTE;

    inline bool IsInitialized() { return control_initialized_; }

    // TODO: Move this and set FSM
    inline void SetControlMode(uint8_t mode) {control_mode_ = mode;}
    inline uint8_t GetControlMode() {return control_mode_;}

    inline const WatchdogRegister_t& GetWatchdog() { return watchdog_; }

    bool CheckErrors();                 // Check for Controller Errors

    inline float GetControlUpdatePeriod() {return controller_update_period_;}

    ADCDevice* GetADC1() const { return adc_1_; }
    ADCDevice* GetADC2() const { return adc_2_; }
    ADCDevice* GetADC3() const { return adc_3_; }

    DRV8323* GetGateDriver() const { return gate_driver_; }

    void CurrentControl(); // Current Control Loop
    void TorqueControl(); // Torque Control Function

    // TODO: Temp will be removed once tools are all finished.
    void PrintConfig();

    // Public for now...  TODO: Need something better here
    uint32_t control_mode_; // Controller Mode

    Config_t config_; // Controller Configuration Parameters
    State_t state_;   // Controller State Struct

    // PWM Variables
    uint16_t pwm_counter_period_ticks_;
    float controller_loop_freq_;
    float controller_update_period_;            // Controller Update Period (Seconds)
    
private:

    float current_max_;                         // Maximum allowed current before clamped by sense resistor

    bool control_thread_ready_;                 // Controller thread ready/active
    bool control_initialized_;                  // Controller thread initialized
    volatile bool control_enabled_;             // Controller thread enabled

    DRV8323 *gate_driver_;    // Gate Driver Device for DRV8323
    SPIDevice *spi_handle_;         // SPI Handle for Communication to Gate Driver

    Motor *motor_; // Motor Object

    bool in_limit_min_; // TODO: Move this to a register
    bool in_limit_max_; // TODO: Move this to a register
    bool in_torque_limit_; // TOOD: Move this to a register

    RMSCurrentLimiter *current_limiter_;
    float rms_current_sample_period_;

    // ADCs
    ADCDevice *adc_1_;
    ADCDevice *adc_2_;
    ADCDevice *adc_3_;
    ADCDevice *vbus_adc_;

    // Thermistors
    Thermistor *fet_therm_;

    // Control FSM
    NomadBLDCFSM* control_fsm_;

    WatchdogRegister_t watchdog_;
    
    //float control_loop_period_;
    static MotorController *singleton_; // Singleton

    // TODO: Should switch this to a abstract com device, uart, can, etc.
    int8_t ClosedLoopTorqueCmd(register_command_t *cmd, FDCANDevice *dev);

};

#endif // CORE_MOTOR_CONTROLLER_H_
