implementedrobotics/Nomad/Hardware/Actuator/NomadBLDC/FirmwareG4/NomadBLDC/Motor.cpp

/*
 * Motor.cpp
 *
 *  Created on: August 26, 2019
 *      Author: Quincy Jones
 *
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
 */

// Primary Include
#include "Motor.h"

// C System Files

// C++ System Files

// Project Includes
#include "MotorController.h"
#include "motor_controller_interface.h"
#include "Logger.h"
#include <RegisterInterface.h>
#include <Utilities/math.h>
#include <Utilities/utils.h>

Motor::Motor(float sample_time, float K_v, uint32_t pole_pairs) : sample_time_(sample_time)
{
    // Zero State
    memset(&state_, 0, sizeof(state_));

    // Setup Default Configs
    config_.num_pole_pairs = pole_pairs;
    config_.continuous_current_max = 20.0f; 
    config_.continuous_current_tau = 60.0f;
    config_.phase_resistance = 0.0f;
    config_.phase_inductance_d = 0.0f;
    config_.phase_inductance_q = 0.0f;
    config_.phase_order = 1;
    config_.calib_current = 10.0f;
    config_.calib_voltage = 2.0f;
    config_.gear_ratio = 1.0f; // No Gearbox by default
    config_.calibrated = 0;

    // Update KV Calulations
    SetKV(K_v);


    // Setup Registers
    RegisterInterface::AddRegister(MotorConfigRegisters_e::MotorConfigRegister1, new Register((MotorConfigRegister1_t *)&config_, true, sizeof(ControllerStateRegister1_t)));
    RegisterInterface::AddRegister(MotorConfigRegisters_e::PolePairs, new Register(&config_.num_pole_pairs));
    RegisterInterface::AddRegister(MotorConfigRegisters_e::K_v, new Register(&config_.K_v));
    RegisterInterface::AddRegister(MotorConfigRegisters_e::K_t, new Register(&config_.K_t));
    RegisterInterface::AddRegister(MotorConfigRegisters_e::K_t_out, new Register(&config_.K_t_out));
    RegisterInterface::AddRegister(MotorConfigRegisters_e::FluxLinkage, new Register(&config_.flux_linkage));
    RegisterInterface::AddRegister(MotorConfigRegisters_e::PhaseResistance, new Register(&config_.phase_resistance));
    RegisterInterface::AddRegister(MotorConfigRegisters_e::PhaseInductanceD, new Register(&config_.phase_inductance_d));
    RegisterInterface::AddRegister(MotorConfigRegisters_e::PhaseInductanceQ, new Register(&config_.phase_inductance_q));
    RegisterInterface::AddRegister(MotorConfigRegisters_e::GearRatio, new Register(&config_.gear_ratio));
    RegisterInterface::AddRegister(MotorConfigRegisters_e::PhaseOrder, new Register(&config_.phase_order));

    RegisterInterface::AddRegister(MotorConfigRegisters_e::MotorThermalConfigRegister, new Register((MotorThermalConfigRegister_t *)&config_.continuous_current_max, true, sizeof(ControllerStateRegister1_t)));
    RegisterInterface::AddRegister(MotorConfigRegisters_e::ContinuousCurrentLimit, new Register(&config_.continuous_current_max));
    RegisterInterface::AddRegister(MotorConfigRegisters_e::ContinuousCurrentTau, new Register(&config_.continuous_current_tau));
    
    RegisterInterface::AddRegister(MotorConfigRegisters_e::MotorCalibrationConfigRegister, new Register((MotorCalibrationConfigRegister_t *)&config_.calib_current, true, sizeof(ControllerStateRegister1_t)));
    RegisterInterface::AddRegister(MotorConfigRegisters_e::CalibrationCurrent, new Register(&config_.calib_current));
    RegisterInterface::AddRegister(MotorConfigRegisters_e::CalibrationVoltage, new Register(&config_.calib_voltage));
    RegisterInterface::AddRegister(MotorConfigRegisters_e::ZeroOutputOffset, new Register(std::bind(&Motor::ZeroOutputPosition, this)));

    RegisterInterface::AddRegister(MotorStateRegisters_e::MotorStateRegister1, new Register((MotorStateRegister1_t *)&state_, true, sizeof(ControllerStateRegister1_t)));
    RegisterInterface::AddRegister(MotorStateRegisters_e::I_A, new Register(&state_.I_a));
    RegisterInterface::AddRegister(MotorStateRegisters_e::I_B, new Register(&state_.I_b));
    RegisterInterface::AddRegister(MotorStateRegisters_e::I_C, new Register(&state_.I_c));
    RegisterInterface::AddRegister(MotorStateRegisters_e::WindingsTemp, new Register(&state_.windings_temp));
    RegisterInterface::AddRegister(MotorStateRegisters_e::OutputPosition, new Register(&state_.theta_mech));
    RegisterInterface::AddRegister(MotorStateRegisters_e::OutputPositionTrue, new Register(&state_.theta_mech_true));
    RegisterInterface::AddRegister(MotorStateRegisters_e::OutputVelocity, new Register(&state_.theta_mech_dot));
    RegisterInterface::AddRegister(MotorStateRegisters_e::ElectricalPosition, new Register(&state_.theta_elec));
    RegisterInterface::AddRegister(MotorStateRegisters_e::ElectricalVelocity, new Register(&state_.theta_elec_dot));

    // Setup Position Sensor
    rotor_sensor_ = new PositionSensorAS5x47(sample_time_, config_.num_pole_pairs);
}

void Motor::PrintConfig()
{
     // Print Configs
    Logger::Instance().Print("Motor Config: PP: %d, I_max: %f, I_tau: %f, R: %f, L_d: %f, L_q: %f\r\n", config_.num_pole_pairs, config_.continuous_current_max, config_.continuous_current_tau, config_.phase_resistance, config_.phase_inductance_d, config_.phase_inductance_q);
    Logger::Instance().Print("Motor Config: K_v: %f, flux_linkage: %f, K_t: %f, K_t_out: %f, Gear: %f\r\n", config_.K_v, config_.flux_linkage, config_.K_t, config_.K_t_out, config_.gear_ratio);
    Logger::Instance().Print("Motor Config: Phase Order: %d, Calib I: %f, Calib V: %f, Calibrated: %d\r\n", config_.phase_order, config_.calib_current, config_.calib_voltage, config_.calibrated);
}

void Motor::SetSampleTime(float sample_time)
{
    sample_time_ = sample_time;
    rotor_sensor_->SetSampleTime(sample_time);
}

void Motor::Update()
{
    // Update Position Sensor
    rotor_sensor_->Update(sample_time_);
    
    // Update State
    state_.theta_mech = rotor_sensor_->GetMechanicalPosition() / config_.gear_ratio;
    state_.theta_mech_true = rotor_sensor_->GetMechanicalPositionTrue() / config_.gear_ratio;
    state_.theta_mech_dot = rotor_sensor_->GetMechanicalVelocity() / config_.gear_ratio;
    state_.theta_elec = rotor_sensor_->GetElectricalPosition();
    state_.theta_elec_dot = rotor_sensor_->GetElectricalVelocity();

    // Update Temparature Observer
}

int8_t Motor::ZeroOutputPosition()
{
    Update(); // Make sure we are updated
    rotor_sensor_->ZeroPosition();
    Update(); // Post update

    return 0;
}

void Motor::SetPolePairs(uint32_t pole_pairs)
{
    config_.num_pole_pairs = pole_pairs;
    
    // Compute other parameters
    config_.flux_linkage = 60.0f / (Core::Math::kSqrt3 * config_.K_v * M_PI * config_.num_pole_pairs * 2);
    config_.K_t = config_.flux_linkage * config_.num_pole_pairs * 1.5f;
    config_.K_t_out = config_.K_t * config_.gear_ratio;
    // Update Rotor
    rotor_sensor_->SetPolePairs(pole_pairs);
}

void Motor::SetKV(float K_v)
{
    config_.K_v = K_v;

    // Compute other parameters
    config_.flux_linkage = 60.0f / (Core::Math::kSqrt3 * config_.K_v * M_PI * config_.num_pole_pairs * 2);
    config_.K_t = config_.flux_linkage * config_.num_pole_pairs * 1.5f;
    config_.K_t_out = config_.K_t * config_.gear_ratio;
}
