implementedrobotics/Nomad/Hardware/Actuator/NomadBLDC/FirmwareG4/NomadBLDC/include/Motor.h

/*
 * Motor.h
 *
 *  Created on: August 24, 2019
 *      Author: Quincy Jones
 *
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
 */

#ifndef CORE_MOTOR_H_
#define CORE_MOTOR_H_

// C System Files

// C++ System Files

// Project Includes
#include "PositionSensor.h"
#include <nomad_hw.h>

class MotorController;
class Motor
{
friend class MotorController;

public:
    // Motor State
    struct State_t
    {
        float I_a;            // Phase A Currents
        float I_b;            // Phase B Currents
        float I_c;            // Phase C Currents

        //float V_a;          // Phase A Voltage
        //float V_b;          // Phase B Voltage
        //float V_c;          // Phase C Voltage
        float windings_temp;  // Motor Windings Temperature (Degrees Celcius)
        float theta_mech;     // Mechanical Position @ Output (Radians)
        float theta_mech_true;// Mechanical Position @ Output w/ Offset (Radians) 
        float theta_mech_dot; // Mechanical Velocity @ Output (Radians/Sec)
        float theta_elec;     // Electrical Position @ Rotor (Radians)
        float theta_elec_dot; // Electrical Velocity @ Rotor (Radians/Sec)


    };

    // Motor Parameters
    struct Config_t
    {
        // Config Reg 1
        uint32_t num_pole_pairs;  // Pole Pairs of Motor (PAIRS)
        // TODO: Just flux linkage?
        float K_v;                // Motor KV Rating (RPM/V)
        float K_t;                // Torque Constant (N*m/A)
        // TOOD: No need to store this.  K_t * K_t_out
        float K_t_out;            // Torque Constant @ Output (N*m/A)
        float flux_linkage;       // Rotor Flux Linkage (Webers)
        float phase_resistance;   // Phase Resistance (Ohms)
        float phase_inductance_d; // D Axis Phase Inductance (Henries)
        float phase_inductance_q; // Q Axis Phase Inductance (Henries)
        // TODO: Custom override for torques if measured experimentally?
        float gear_ratio;         // Gear Box Ratio
        int32_t phase_order;      // Winding Phase Order

        // Thermal Config Reg
        float continuous_current_max; // Thermally calibrated Allowable Continuous Current (A)
        float continuous_current_tau; // Time Constant for Continuous Current (Seconds)
        uint32_t tcr_reserved[6]; // Reserved

        // Calibration Config Reg
        // TODO: Kill these 2 and pass in per calibration
        float calib_current;      // Calibration Current
        float calib_voltage;      // Calibration Voltage
        // TODO: This has to be better
        int32_t calibrated;          // Calibrated
        uint32_t ccr_reserved[5];   // Reserved
    };

    Motor(float sample_time=0.000025f, float K_v = 100, uint32_t pole_pairs = 21);

    void SetPolePairs(uint32_t pole_pairs);            // Set Motor Pole Count
    void SetKV(float K_v);                             // Set Motor KV Rating
    int8_t ZeroOutputPosition();                         // Zero Mechanical Position Offset
    bool Calibrate(MotorController *controller);       // Calibrate Motor Routine
    void SetSampleTime(float sample_time);             // Update controller sample rate
    void CCM_ATTRIBUTE Update(); // Update Motor State

    inline PositionSensorAS5x47* PositionSensor() { return rotor_sensor_; }

    void PrintConfig();
    //bool WriteConfig(); // Write Configuration to Flash Memory
    //bool ReadConfig();  // Read Configuration from Flash Memory
    
    State_t state_;  // Motor State
    Config_t config_; // Motor Params
    
private:
    
    float sample_time_; // Update Sample Time (=Current Control Update Rate)

    PositionSensorAS5x47 *rotor_sensor_; // Rotor Position Sensor
};

#endif // CORE_MOTOR_H_
