implementedrobotics/Nomad/Hardware/Actuator/NomadBLDC/FirmwareG4/NomadBLDC/include/PositionSensor.h

/*
 * PositionSensor.h
 *
 *  Created on: August 24, 2019
 *      Author: Quincy Jones
 *
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
 */

#ifndef CORE_POSITION_SENSOR_H_
#define CORE_POSITION_SENSOR_H_

// C System Files

// C++ System Files

// Project Includes
#include <Peripherals/spi.h>
#include <nomad_hw.h>

class PositionSensorAS5x47
{

public:
    // Encoder Parameters
    struct Config_t
    {
        // Encoder Config Register
        float offset_elec;       // Electrical Position Offset (Radians)
        float offset_mech;       // Mechanical Position Offset (Radians)
        int32_t cpr;             // Sensor Counts Per Revolution
        uint32_t reserved[4];
        //int32_t direction;       // Sensor Direction for Positive Rotation

        // Config Offset LUT Registers
        int8_t offset_lut[128]; // Offset Lookup Table
    };

    PositionSensorAS5x47(float sample_time, uint32_t pole_pairs = 21, uint32_t cpr = 16384); // Constructor with some initial defaults.

    void SetCPR(int32_t cpr);                     // Set Sensor Counts Per Revolution
    void SetElectricalOffset(float offset);       // Set Sensor Electrical Position Offset, Distance to A Axis (radians)
    void SetMechanicalOffset(float offset);       // Set Sensor Mechanical Position Offset, Output "zero" point (radians)
    void SetOffsetLUT(int8_t lookup_table[128]); // Non-Linearity Lookup Table (Helps with position sensor installation offset)
    void SetPolePairs(uint32_t pole_pairs);       // Set Pole Pair Count for Electrical Position Calculations
    void SetDirection(int32_t direction);         // Sensor Direction
    void SetSampleTime(float sample_time);        // Update controller sample rate
    void Reset();                                 // Reset position sensor to defaults, i.e. ignore any saved/restored settings
    void ZeroPosition(); // Zero Mechanical Position Offset

    inline float GetElectricalOffset() { return config_.offset_elec; }
    inline int32_t GetCPR() { return config_.cpr;}
    inline int32_t GetRawPosition() { return position_raw_; }                                 // Get Sensor Raw Position (counts)
    inline int32_t GetNumRotations() { return num_rotations_; }                 // Get number of sensor rotations
    inline float GetElectricalPosition() { return position_electrical_; }                    // Get Sensor Electrical Position w/ Offset, Distance to A Axis (radians)
    inline float GetMechanicalPosition() { return position_mechanical_; }                    // Get Sensor Mechanical Position w/ Offset, (radians)
    inline float GetMechanicalPositionTrue() { return (position_mechanical_ + config_.offset_mech); } // Get Sensor Real Mechanical Position without Offset, (radians)
    inline float GetElectricalVelocity() { return velocity_electrical_; }                    // Get Sensor Electrical Velocity (radians/sec)
    inline float GetElectricalVelocityFiltered() { return velocity_electrical_filtered_ ; }                    // Get Sensor Electrical Velocity Filtered (radians/sec)
    inline float GetMechanicalVelocity() { return velocity_mechanical_ ; }                    // Get Sensor Mechanical Velocity (radians/sec)
    void CCM_ATTRIBUTE StartUpdate();
    void CCM_ATTRIBUTE EndUpdate();
    void CCM_ATTRIBUTE Update();         // Update Position Sensor State w/ Implciit Sample Time (for velocity estimation)
    void CCM_ATTRIBUTE Update(float Ts); // Update Position Sensor State w/ Sample Time (for velocity estimation)

    bool WriteConfig(Config_t config); // Write Configuration to Flash Memory
    bool ReadConfig(Config_t config);  // Read Configuration from Flash Memory

    void PrintConfig();
    Config_t config_;     // Position Sensor Configuration Parameters
    
private:
    float position_electrical_;          // Sensor Electrical Position (radians)
    float position_mechanical_;          // Sensor Mechanical Position (radians)
    float position_normalized_;          // Sensor Mechanical Position Modulo/Normalized [0-2*PI] (radians)
    float velocity_electrical_;          // Sensor Electrical Velocity (radians/sec)
    float velocity_electrical_filtered_; // Sensor Filtered Electrical Velocity (radians/sec)
    float velocity_mechanical_;          // Sensor Mechanical Velocity (radians/sec)
    float *velocity_samples_;            // Array to hold velocity samples for filtering/estimation
    int32_t position_raw_;               // Sensor Raw Position (counts)
    int32_t num_rotations_;              // Keep Track of Sensor Rotations

    // TODO: Redundant.  Also in motor.  Should only track one variable
    // Move to HW config
    uint32_t pole_pairs_;                // Pole Pairs in Motor to Compute Electrical Positions

    int32_t filter_size_; // Velocity Filter Window Size
    
    SPIDevice *spi_dev_; // SPI Device for Communication to Sensor

    float sample_time_; // Update Sample Time (=Current Control Update Rate)
    bool dirty_; // Have unsaved changes to config
};

#endif // CORE_POSITION_SENSOR_H_
