implementedrobotics/Nomad/Hardware/Actuator/NomadBLDC/Drivers/NomadBLDC/include/NomadBLDC/Registers.h

/*
 * Registers.h
 *
 *  Created on: March 8, 2021
 *      Author: Quincy Jones
 *
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
 */

#ifndef CAN_REGISTERS_H_
#define CAN_REGISTERS_H_

#include <stdint.h>

struct request_header_t // 4 Bytes
{
    uint32_t sender_id : 5; // Node ID of Sender
    uint32_t ACK : 1;       // ACK Request
    uint32_t rwx : 2;       // Read/Write/Execute
    uint32_t address : 8;   // 8-bit address (256 Max Addresses)
    uint32_t data_type : 2; // Data Type: 8-bit fixed, 16-bit fixed, 32-bit fixed, 32-bit float
    uint32_t msg_id : 14;    // MSG/ACK ID
};

struct response_header_t // 4 Bytes
{
    uint32_t sender_id : 5; // Node ID of Sender
    uint32_t reserved : 1; // Reserved/Padding
    uint32_t address : 8;   // 8-bit address (256 Max Addresses)
    uint32_t code : 4;      // Return Code
    uint32_t msg_id : 14;     // MSG/ACK ID
};

struct register_command_t
{
    union
    {
        struct
        {
            request_header_t header; // Command Header
            uint8_t cmd_data[60];    // Command Data Buffer Payload
        };
        uint8_t data[64]; // Full 64-byte command buffer FDCAN
    };
};

struct register_reply_t
{
    union // Union for mapping the full 64-byte data packet
    {
        struct
        {
            response_header_t header; // Response Reply Header
            uint8_t cmd_data[60];     // Data Buffer Return
        };
        uint8_t data[64]; // Full 64-byte command buffer FDCAN
    };
};

struct Register
{
    uint32_t address;
    size_t size;
    uint8_t *data;
};

// Request Type
typedef enum
{
    Read = 0,
    Write = 1,
    Execute = 2
} RequestType_e;

/* Device Registers */
typedef enum // Device Status Register
{
    DeviceStatusRegister1 = 0x00,
    // Device Status Register 1 Offsets
    DeviceFault = 0x01,
    DeviceControlMode = 0x02,
    DeviceVoltageBus = 0x03,
    DeviceCurrentBus = 0x04,
    DeviceFETTemp = 0x05,
    DeviceSaveConfig = 0x06,
    DeviceLoadConfig = 0x07,
    DeviceRestart = 0x08,
    // Reserved = 0x06,
    // Reserved = 0x07,
    // Reserved = 0x08,
    // Reserved = 0x09,
    // Reserved = 0x0A,
    // Reserved = 0x0B,
    // End Device Status Register 1

    DeviceStatusRegister2 = 0x0C,
    // Device Status Register2 Offsets
    DeviceFirmwareMajor = 0x0D,
    DeviceFirmwareMinor = 0x0E,
    DeviceUID1 = 0x0F,
    DeviceUID2 = 0x10,
    DeviceUID3 = 0x11,
    DeviceUptime = 0x12,
    // Reserved = 0x13,
    // Reserved = 0x14,
    // Reserved = 0x15,
    // End Device Status Register 2
} DeviceRegisters_e;

/* Motor Controller Registers */
typedef enum // Controller Config Register
{
    ControllerConfigRegister1 = 0x16,
    // Controller Config Register 1 Offsets
    K_LOOP_D = 0x17,         // Current Controller Loop Gain (D Axis)
    K_LOOP_Q = 0x18,         // Current Controller Loop Gain (Q Axis)
    K_I_D = 0x19,            // Current Controller Integrator Gain (D Axis)
    K_I_Q = 0x1A,            // Current Controller Integrator Gain (Q Axis)
    K_I_VEL = 0x1B,          // Velocity Integrator Gain
    CurrentBandwidth = 0x1C, // Current Loop Bandwidth (200 to 2000 hz)
    Overmodulation = 0x1D,   // Overmodulation Amount
    PWM_Frequency = 0x1E,    // PWM Switching Frequency
    FOC_Divider = 0x1F,      // Divider to use for FOC Current control loop frequency
    // Reserved = 0x20,
    // Reserved = 0x21,
    // End Controller Config Register 1

    ControllerConfigRegister2 = 0x22,
    // Controller Config Register 2 Offsets
    K_P_Max = 0x23,
    K_D_Max = 0x24,
    K_P_Limit = 0x25,         // Position Limiting Mode Proportional Gain
    K_D_Limit = 0x26,         // Position Limiting Mode Derivative Gain
    PositionLimitMin = 0x27,     // Limit on position input max
    PositionLimitMax = 0x28,     // Limit on position input min
    VelocityLimit = 0x29, // Limit on maximum velocity
    PositionLimit = 0x2A, // Limit on maximum position
    TorqueLimit = 0x2B,   // Limit on maximum torque
    CurrentLimit = 0x2C,  // Limit on maximum current
    // Reserved = 0x2D,
    // Reserved = 0x2E,
    // Reserved = 0x2F,
    // End Device Status Register 2
} ControllerConfigRegisters_e;

typedef enum // Controller State Register
{
    ControllerStateRegister1 = 0x30,
    // Controller State Register 1 Offsets
    I_D = 0x31,               // Transformed Current (D Axis)
    I_Q = 0x32,               // Transformed Current (Q Axis)
    V_D = 0x33,               // Voltage (D Axis)
    V_Q = 0x34,               // Voltage (Q Axis)
    IntegratorError_D = 0x35, // Current Integral Error (D Axis)
    IntegratorError_Q = 0x36, // Current Integral Error (Q Axis)
    DutyCycleA = 0x37,        // Duty Cycle for A phase
    DutyCycleB = 0x38,        // Duty Cycle for B phase
    DutyCycleC = 0x39,        // Duty Cycle for C phase
    CurrentRMS = 0x3A,        // Motor RMS Current Value
    MaxCurrent = 0x3B,        // Maximum Allowable Commanded Current in next Time Step
    DeadlineMissed = 0x3C,           // Missed Input Control Deadline Count
    ControlMode = 0x3D,       // Set Control Mode.  TODO: Should be a function instead and in new register
    IntegratorError_Vel = 0x3E,
    // Reserved = 0x3F,
    // End Controller State Register 1

    ControllerStateRegister2 = 0x40,
    // Controller State Register 2 Offsets
    VoltageControlModeRegister = 0x41,
    // Voltage Control Register Offsets
    V_Setpoint_D = 0x42, // Voltage Reference (D Axis)
    V_Setpoint_Q = 0x43, // Voltage Reference (Q Axis)
    ThetaRef = 0x44,        // Rotor Angle Reference (Optional used primarily for calibration/open loop mode)
    // Current Control Register Offsets
    CurrentControlModeRegister = 0x45,
    I_Setpoint_D = 0x46, // Current Reference (D Axis)
    I_Setpoint_Q = 0x47, // Current Reference (Q Axis)
    // Torque Control Register Offsets
    TorqueControlModeRegister = 0x48,
    PositionSetpoint = 0x49, // Position Setpoint Reference
    K_P = 0x4A,              // Position Gain N*m/rad
    VelocitySetpoint = 0x4B, // Velocity Setpoint Reference
    K_D = 0x4C,              // Velocity Gain N*m/rad/s
    Torque_FF = 0x4D,        // Feed Forward Torque Value N*m
    VoltageBus = 0x4E,
    CurrentBus = 0x4F,
    FETTemp = 0x50,
    // End Controller State Register 2
} ControllerStateRegisters_e;


/* Motor Registers */
typedef enum // Motor Config Register
{
    MotorConfigRegister1 = 0x51,
    // Motor Config Register 1 Offsets
    PolePairs = 0x52,        // Pole Pairs of Motor (PAIRS)
    K_v = 0x53,              // Motor KV Rating (RPM/V)
    K_t = 0x54,              // Torque Constant (N*m/A)
    K_t_out = 0x55,          // Torque Constant @ Output (N*m/A)
    FluxLinkage = 0x56,      // Rotor Flux Linkage (Webers)
    PhaseResistance = 0x57,  // Phase Resistance (Ohms)
    PhaseInductanceD = 0x58, // D Axis Phase Inductance (Henries)
    PhaseInductanceQ = 0x59, // Q Axis Phase Inductance (Henries)
    GearRatio = 0x5A,
    PhaseOrder = 0x5B,
    // End Motor Config Register 1

    MotorThermalConfigRegister = 0x5C, // Thermal Config Register
    // Motor Thermal Config Register Offsets
    ContinuousCurrentLimit = 0x5D, // Thermally calibrated Allowable Continuous Current (A)
    ContinuousCurrentTau = 0x5E,   // Time Constant for Continuous Current (Seconds)
    //Reserved = 0x5F,  // Observer Temp
    //Reserved = 0x60,  // Observer Resistance
    //Reserved = 0x61,  // Thermal Capacitance
    //Reserved = 0x62,  // R Theta
    //Reserved = 0x63,
    //Reserved = 0x64,
    // End Motor Thermal Config Register

    MotorCalibrationConfigRegister = 0x65, // Motor Calibration Config Register
    // Motor Calibration Config Register Offsets
    CalibrationCurrent = 0x66,
    CalibrationVoltage = 0x67,
    Calibrated = 0x68,
    ZeroOutputOffset = 0x69,
    //Reserved = 0x6A,
    //Reserved = 0x6B,
    //Reserved = 0x6C,
    // End Motor Calibration Config Register
} MotorConfigRegisters_e;

typedef enum // Motor State Register
{
    MotorStateRegister1 = 0x6D,
    // Motor State Register 1 Offsets
    I_A = 0x6E, // Phase A Currents
    I_B = 0x6F, // Phase B Currents
    I_C = 0x70, // Phase C Currents
    //V_A = 0x71,               // Phase A Voltages
    //V_B = 0x72,               // Phase B Voltages
    //V_C = 0x73,               // Phase C Voltages
    WindingsTemp = 0x74,        // Motor Windings Temperature (Degrees Celcius)
    OutputPosition = 0x75,     // Mechanical Position @ Output (Radians)
    OutputPositionTrue = 0x76, // Mechanical Position @ Output w/ Offset (Radians)
    OutputVelocity = 0x77,     // Mechanical Velocity @ Output (Radians/Sec)
    ElectricalPosition = 0x78, // Electrical Position @ Rotor (Radians)
    ElectricalVelocity = 0x79, // Electrical Velocity @ Rotor (Radians/Sec)
                               // Reserved = 0x7A,
                               // Reserved = 0x7B,
                               // Reserved = 0x7C,
    // End Motor State Register 1
} MotorStateRegisters_e;

/* Encoder Registers */
typedef enum // Encoder Config Register
{
    EncoderConfigRegister1 = 0x80,
    // Encoder Config Register Offsets
    ElectricalOffset = 0x81, // Electrical Position Offset (Radians)
    MechanicalOffset = 0x82, // Mechanical Position Offset (Radians)
    CPR = 0x83,              // Counts Per Revolution
    // Reserved = 0x84,
    // Reserved = 0x85,
    // Reserved = 0x86,
    // Reserved = 0x87,
    // End Encoder Config Register 1
    EncoderConfigOffsetLUT1 = 0x88, // 1st 32-bytes
    EncoderConfigOffsetLUT2 = 0x89, // 2nd 32-bytes
    EncoderConfigOffsetLUT3 = 0x8A, // 3rd 32-bytes
    EncoderConfigOffsetLUT4 = 0x8B, // Last 32-bytes (128 Bytes Total)

} EncoderConfigRegisters_e;

/* CAN Config Registers */
typedef enum // CAN Config Register
{
    CANConfigRegister1 = 0x8C,
    // CAN Config Register Offsets
    ID = 0x8D,             // CAN ID 11-bit max is 0x7ff
    Bitrate = 0x8E,        // Nominal Bitrate
    DataBitrate = 0x8F,    // Data Bitrate
    FD_MODE = 0x90,        // FD mode or classic
    SamplePoint = 0x91,   // Nominal Bitrate Sample Point Target
    DataSamplePoint = 0x92, // Data Sample Point Target

} CANConfigRegisters_e;

/* UART Config Registers */

/* Misc Config Registers */

/* Error State Registers */

/* Gate Drive Registers */

/* Motor Controller Registers */
typedef enum // Controller Config Register
{
    ClosedLoopTorqueCommand = 0xC8, // Optimized Closed Loop Torque Command Function
    JointStateRegister = 0xC9, // Optimized Closed Loop Joint State Register

} ControllerCommandRegisters_e;

/* Watchdog Registers */
typedef enum // Controller Config Register
{
    CommandTime = 0xCA, // Last received command time
    Timeout = 0xCB, // Timeout in ms

} WatchdogRegisters_e;

// TODO: Current Sense Amp Options

// TODO: Where to put this?
struct DeviceStatusRegister1_t
{
    uint16_t fault_mode;   // Fault Mode
    uint16_t control_mode; // Controller Mode
    float V_bus;           // Voltage Bus
    float I_bus;           // Current Bus
    float fet_temp;        // FET Temperatures
};

struct DeviceStatusRegister2_t
{
    uint8_t fw_major;          // Firmware Version Major
    uint8_t fw_minor;          // Firmware Version Minor
    uint32_t uid1;             // Device Unique ID 1
    uint32_t uid2;           ;         // Position Limiting Mode Derivative Gain  // Device Unique ID 2
    uint32_t uid3;             // Device Unique ID 3
    uint32_t uptime;           // Device Uptime
};

struct ControllerConfigRegister1_t
{
    float k_d;                // Current Controller Loop Gain (D Axis)
    float k_q;                // Current Controller Loop Gain (Q Axis)
    float k_i_d;              // Current Controller Integrator Gain (D Axis)
    float k_i_q;              // Current Controller Integrator Gain (Q Axis)
    float k_i_vel;            // Velocity Integrator Gain
    float current_bandwidth;  // Current Loop Bandwidth (200 to 2000 hz)
    float overmodulation;     // Overmodulation Amount
    float pwm_freq;           // PWM Switching Frequency
    uint32_t foc_ccl_divider; // Divider to use for FOC Current control loop frequency
};

struct ControllerConfigRegister2_t
{
    float K_p_min;            // Position Gain Minimum
    float K_p_max;            // Position Gain Maximum
    float K_d_min;            // Velocity Gain Minimum
    float K_d_max;            // Velocity Gain Maximum
    float velocity_limit;     // Limit on maximum velocity
    float position_limit;     // Limit on position input
    float torque_limit;       // Torque Limit
    float current_limit;      // Max Current Limit
};

struct ControllerStateRegister1_t
{
    float I_d;        // Transformed Current (D Axis)
    float I_q;        // Transformed Current (Q Axis)
    float V_d;        // Voltage (D Axis)
    float V_q;        // Voltage (Q Axis)
    float d_int;      // Current Integral Error
    float q_int;      // Current Integral Error
    float dtc_A;      // Duty Cycle for A phase
    float dtc_B;      // Duty Cycle for B phase
    float dtc_C;      // Duty Cycle for C phase
    float I_rms;      // Motor RMS Current Value
    float I_max;      // Maximum Allowable Commanded Current in next Time Step
    uint32_t timeout; // Keep up with number of controller timeouts for missed deadlines
    float Vel_int;    // Velocity Integrator Error
};

struct ControllerStateRegister2_t
{
    // Voltage Control Setpoints
    float V_d_ref; // Voltage Reference (D Axis)
    float V_q_ref; // Voltage Reference (Q Axis)

    // Current Control Setpoints
    float I_d_ref; // Current Reference (D Axis)
    float I_q_ref; // Current Reference (Q Axis)

    // Torque Control Setpoints
    float Pos_ref; // Position Setpoint Reference
    float K_p;     // Position Gain N*m/rad
    float Vel_ref; // Velocity Setpoint Reference
    float K_d;     // Velocity Gain N*m/rad/s
    float T_ff;    // Feed Forward Torque Value N*m

    // Still figuring out the best place for these
    float Voltage_bus;
    float I_bus;
    float fet_temp;
};

struct VoltageControlModeRegister_t
{
    float V_d_ref; // Voltage Reference (D Axis)
    float V_q_ref; // Voltage Reference (Q Axis)
};

struct CurrentControlModeRegister_t
{
    float I_d_ref; // Current Reference (D Axis)
    float I_q_ref; // Current Reference (Q Axis)
};

struct TorqueControlModeRegister_t
{
    float Pos_ref; // Position Setpoint Reference
    float K_p;     // Position Gain N*m/rad
    float Vel_ref; // Velocity Setpoint Reference
    float K_d;     // Velocity Gain N*m/rad/s
    float T_ff;    // Feed Forward Torque Value N*m
};

struct ModulationControlModeRegister_t
{
    float V_d_ref; // Voltage Reference (D Axis)
    float V_q_ref; // Voltage Reference (Q Axis)
    float theta;   // Rotor Angle Reference
};

struct JointState_t
{
    float Pos;   // Position Estimate
    float Vel;  // Velocity Estimate
    float T_est; // Torque Estimate
};

struct MotorConfigRegister1_t
{
    uint32_t num_pole_pairs;      // Pole Pairs of Motor (PAIRS)
    float phase_resistance;       // Phase Resistance (Ohms)
    float phase_inductance_d;     // D Axis Phase Inductance (Henries)
    float phase_inductance_q;     // Q Axis Phase Inductance (Henries)

    // TODO: Just flux linkage?
    float K_v;          // Motor KV Rating (RPM/V)
    float flux_linkage; // Rotor Flux Linkage (Webers)
    float K_t;          // Torque Constant (N*m/A)

    // TOOD: No need to store this.  K_t * K_t_out
    float K_t_out; // Torque Constant @ Output (N*m/A)
    // TODO: Custom override for torques if measured experimentally?
    float gear_ratio;    // Gear Box Ratio
    int32_t phase_order; // Winding Phase Order
};

struct MotorThermalConfigRegister_t
{
    float continuous_current_max; // Thermally calibrated Allowable Continuous Current (A)
    float continuous_current_tau; // Time Constant for Continuous Current (Seconds)
};

struct MotorCalibrationConfigRegister_t
{
    float calib_current; // Calibration Current
    float calib_voltage; // Calibration Voltage
    int32_t calibrated; // Calibrated
};

struct MotorStateRegister1_t
{
    float I_a; // Phase A Currents
    float I_b; // Phase B Currents
    float I_c; // Phase C Currents

    //float V_a;          // Phase A Voltage
    //float V_b;          // Phase B Voltage
    //float V_c;          // Phase C Voltage

    float theta_mech;      // Mechanical Position @ Output (Radians)
    float theta_mech_dot;  // Mechanical Velocity @ Output (Radians/Sec)
    float theta_mech_true; // Mechanical Position @ Output w/ Offset (Radians)
    float theta_elec;      // Electrical Position @ Rotor (Radians)
    float theta_elec_dot;  // Electrical Velocity @ Rotor (Radians/Sec)

    float windings_temp; // Motor Windings Temperature (Degrees Celcius)
};

struct EncoderConfigRegister1_t
{
    float offset_elec; // Electrical Position Offset (Radians)
    float offset_mech; // Mechanical Position Offset (Radians)
    int32_t cpr;       // Sensor Counts Per Revolution
};

struct EncoderConfigOffsetLUT1_t
{
    int8_t offset_lut[32]; // Offset Lookup Table 1
};

struct EncoderConfigOffsetLUT2_t
{
    int8_t offset_lut[32]; // Offset Lookup Table 2
};

struct EncoderConfigOffsetLUT3_t
{
    int8_t offset_lut[32]; // Offset Lookup Table 3
};

struct EncoderConfigOffsetLUT4_t
{
    int8_t offset_lut[32]; // Offset Lookup Table 4
};

struct CANConfigRegister1_t
{
    uint32_t id;          // CAN ID 11-bit max is 0x7ff
    uint32_t bitrate;     // Nominal Bitrate
    uint32_t d_bitrate;   // Data Bitrate
    uint32_t mode_fd;     // FD mode or classic
    float sample_point;   // Nominal Bitrate Sample Point Target
    float d_sample_point; // Data Sample Point Target
};

struct WatchdogRegister_t
{
    int32_t command_time;
    int32_t timeout;
};

#endif // CAN_REGISTERS_H_ControllerStateRegisters_e
