implementedrobotics/Nomad/Hardware/Actuator/NomadBLDC/Tools/Commands.py

"""Nomad Class Handler for Interaction with NomadBLDC Board"""

#  Commands.py
#
#  Created on: March 20, 2020
#      Author: Quincy Jones
# 
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

from enum import IntEnum
import struct
import time
import threading
from DataContainers import *

#from collections import namedtuple
#from typing import NamedTuple

class CommandID(IntEnum):
    # Info/Status Commands
    DEVICE_INFO_READ = 1
    DEVICE_STATS_READ = 2
    DEVICE_CONFIG_READ = 3

    # Configuration Commands
    MEASURE_RESISTANCE = 4
    MEASURE_INDUCTANCE = 5
    MEASURE_PHASE_ORDER = 6
    MEASURE_ENCODER_OFFSET = 7
    ZERO_MECHANICAL_OFFSET = 8

    # Motor Control Commands
    ENABLE_CURRENT_CONTROL = 9
    ENABLE_VOLTAGE_CONTROL = 10
    ENABLE_TORQUE_CONTROL  = 11
    ENABLE_SPEED_CONTROL   = 12
    ENABLE_IDLE_MODE       = 13

    READ_MOTOR_STATE = 14
    READ_CONTROLLER_STATE = 15
    READ_ENCODER_STATE = 16
    READ_MOTOR_CONFIG = 17
    READ_CONTROLLER_CONFIG = 18
    READ_ENCODER_CONFIG = 19
    READ_CAN_CONFIG = 20
    READ_UART_CONFIG = 21
    WRITE_MOTOR_CONFIG = 22
    WRITE_CONTROLLER_CONFIG = 23
    WRITE_ENCODER_CONFIG = 24
    WRITE_CAN_CONFIG = 25
    WRITE_UART_CONFIG = 26
    WRITE_FLASH = 27

    # Device Control Commands
    DEVICE_RESTART = 28
    DEVICE_ABORT   = 29
    
    # Set Points
    SEND_VOLTAGE_SETPOINT = 30
    SEND_CURRENT_SETPOINT = 31
    SEND_TORQUE_SETPOINT = 32

    # Status
    LOGGING_OUTPUT = 100
    CALIBRATE_MOTOR = 101

class CommandHandler:
    def __init__(self):
        self.timeout = 11

        # Events
        self.device_info_received = threading.Event()
        self.device_stats_received = threading.Event()
        self.motor_config_received = threading.Event()
        self.controller_config_received = threading.Event()
        self.encoder_config_received = threading.Event()
        self.can_config_received = threading.Event()
        
        self.motor_state_received = threading.Event()
        self.controller_state_received = threading.Event()
        self.encoder_state_received = threading.Event()

        self.resistance_measurement_complete = threading.Event()
        self.inductance_measurement_complete = threading.Event()
        self.phase_order_measurement_complete = threading.Event()
        self.encoder_offset_measurement_complete = threading.Event()
        self.write_flash_complete = threading.Event()
        self.status = None
        self.measurement = None
        self.device_stats = None
        self.motor_config = None
        self.encoder_config = None
        self.controller_config = None
        self.can_config = None
        
        self.motor_state = None
        self.encoder_state = None
        self.controller_state = None

        self.logger_cb = None
    
    def set_logger_cb(self, cb):
        self.logger_cb = cb 

    # Mechnical Offset
    def zero_mechanical_offset(self, transport):
        command_packet = bytearray(struct.pack("<BB", CommandID.ZERO_MECHANICAL_OFFSET, 0))
        transport.send_packet(command_packet)

    # Measure Encoder Offset
    def measure_motor_encoder_offset(self, transport):
        command_packet = bytearray(struct.pack("<BB", CommandID.MEASURE_ENCODER_OFFSET, 0))
        transport.send_packet(command_packet)

        # Wait for device response
        self.encoder_offset_measurement_complete.wait(30)
        if(self.encoder_offset_measurement_complete.is_set()):
            self.encoder_offset_measurement_complete.clear() # Clear Flag
            return self.measurement
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
