implementedrobotics/Nomad/(commit log)

2019-05-09 Add swing leg trajectories and cleanup.
    Also added rendering of the step, and added additional gaits
    Bounding, Pronking.
2019-05-10 Fix major bug with Inertia Matrix
    Changed multiplication from '*' to proper python way of '@'. Was causing instability at certain yaw angles.
2019-05-17 Major Bug Fixes
    Revised foot placement controller
    Added reference frames to models
    Still need future foot placement -> MPC
    Ready for test in a physics simulator
2019-06-19 Add thread queue testing class
2019-06-29 Add integrator
    [rbdl_test.csv]
2019-07-05 More FrameWork. Add Gazebo worls. Renaming.
    [model.sdf]
2019-07-07 Update Licenses. Add Block Diagonal Routines
    [rbdl_test.csv]
2019-07-12 Add threaded ZMQ Test
2019-07-13 Begin ZMQ Thread Messaging. Also add CPU Affinity Optiopns
2019-07-18 Start Leg Controller
2019-07-22 More work on ZMQ Blocking. Also working on eigen segfault bug.
    [ConvexMPC.cpp, RealTimeTask.cpp, RealTimeTask.hpp, ReferenceTrajectoryGen.cpp, StateEstimator.cpp]
2019-07-23 Eigen Segfault Final Fix
    [ConvexMPC.cpp]
2019-07-24 [BROKEN COMMS] Discovered an issue with ZMQ_CONFLATE and inproc sockets.
    [ConvexMPC.cpp, ConvexMPC.hpp, Messages.hpp, RealTimeTask.cpp, RealTimeTask.hpp, ReferenceTrajectoryGen.cpp, ReferenceTrajectoryGen.hpp]
2019-07-25 Switch to IPC
2019-07-26 Add Thread Locking and Removed some Debug.
2019-08-03 More plotting. Need to fix signal labelling bug.
    [StateEstimator.cpp, matplotlibcpp.h]
2019-08-04 Fix port label bugs.
    [ConvexMPC.cpp, PlotterTaskNode.hpp, ReferenceTrajectoryGen.cpp, StateEstimator.cpp]
2019-08-04 Fix shared pointers, etc.
    [ConvexMPC.cpp, ConvexMPC.hpp, PlotterTaskNode.hpp, RealTimeTask.cpp, RealTimeTask.hpp]
2019-08-09 Time Scale bug fixes. Getting closer to the full loop feedback.
    [ConvexMPC.cpp, ReferenceTrajectoryGen.cpp]
2019-08-10 Slightly broken with some memory issues.
    [ConvexMPC.cpp, ReferenceTrajectoryGen.cpp]
2019-08-12 Updates and refactor. Ready for UDP testing to out of process nodes(Gazebo)
    [model.sdf]
2019-08-18 Bug fixes. Including Several Thread Exit Crashes.
    Also fix eigen stack allocation issues.
    [RealTimeTask.cpp, RealTimeTask.hpp, StateEstimator.cpp]
2019-08-21 Initial Commit For BLDC Hardware
2019-08-22 Fix CPR bug on spi.
    [PositionSensor.cpp, main.cpp]
2019-08-22 Add testing for T-Motor U10
2019-08-23 create files
    [PCB_V1.2.kicad_pcb, PCB_V1.2.sch]
2019-08-23 Removed directory
    [PCB_V1.2.kicad_pcb, PCB_V1.2.sch]
2019-08-24 Changes to schematic
    [PCB_V1.2.sch]
2019-08-24 changes to value names of PCB
    [PCB_V1.2.kicad_pcb]
2019-08-25 Add Position Sensor
2019-08-25 Position Sensor Ported
2019-08-25 Thread Signals Working. Porting PWM.
2019-08-26 Added PWM/ADC Hardware Setup. Still need to test.
2019-08-26 Add current measurement callback.
2019-08-26 Add Motor Object
2019-08-27 Add LED Type
2019-08-28 Add DSP Library. Measure Motor Parameters
2019-08-29 Flash Saving Configuration. Added Reboot
    [Motor.cpp, Motor.h, MotorController.cpp, MotorController.h, PositionSensor.h, main.cpp, motor_controller_interface.h]
2019-08-30 Phase/Encoder Direction Added. TODO: Test!
2019-09-02 Add STM32 CubeMX for STM32G4
2019-09-02 Refactor Encoder Offset. Need to test.
2019-09-03 Position Calibration Ported
2019-09-03 Fix Offset Table Bug
    [Motor.cpp]
2019-09-04 Updates and Bug Fixes. Ready for the FOC loop.
    [Motor.cpp, Motor.h, MotorController.cpp, PositionSensor.cpp, PositionSensor.h, main.cpp, motor_controller_interface.h]
2019-09-04 Add More Debug Print Menus
2019-09-04 Add Current Loop Gain Config. Also Redo TIMING #Defines
2019-09-04 Add Current Control FOC Loop
2019-09-04 Add Torque Control Computation
2019-09-05 Current Controller Functional.
2019-09-07 Fix controller bug. Add more user menus
    Add more fault checks/errors
    [Motor.h, MotorController.cpp, MotorController.h, PositionSensor.h, main.cpp, motor_controller_interface.h]
2019-09-07 Add a quick/dirty debug print mode
2019-10-11 init repo
    [BOM_PCBWay.xlsx, CENTROID_PCBWay.xlsx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]
2019-10-13 updated some files
    [BOM_PCBWay.xlsx, PCB_V1.3.kicad_pcb, PCB_V1.3.sch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]
2019-10-13 new files
    [PCB_V1.3_CSD-B_Mask.gbs, PCB_V1.3_CSD-B_Paste.gbp, PCB_V1.3_CSD-B_SilkS.gbo, PCB_V1.3_CSD-Bottom.gbl, PCB_V1.3_CSD-Edge_Cuts.gm1, PCB_V1.3_CSD-F_Mask.gts, PCB_V1.3_CSD-F_Paste.gtp, PCB_V1.3_CSD-F_SilkS.gto]
2020-03-19 Update Enable PIN
2020-03-21 Fix thread close hang. Refactor HDLC packet framing function.
    [Commands.py, HDLCHandler.py, NomadBLDC.py, SerialHandler.py]
2020-03-21 Successful Device Info Read.
2020-03-22 More functions added. Torque Control needs double checking.
2020-03-23 Update GUI. Drop Control Loop to 20khz, PWM @ 40khz. Gives more headroom for comms...
2020-03-28 Add threading basic support. Switch to CB for phase value
2020-03-29 Better UI threads and signalling. A little priority issue with comms in inducatance measurement mode. Also have a bug with inductance progress not going away.
    [CommandHandler.cpp, CommandHandler.h, Commands.py, DataContainers.py, Motor.cpp, Motor.h, MotorController.cpp, MotorController.h]
2020-03-29 Misc. fixes, and add phase order measurement.
    [CommandHandler.cpp, CommandHandler.h, Commands.py, DataContainers.py, HDLCHandler.py, Motor.cpp, MotorController.cpp, MotorController.h]
2020-03-29 Fix comm bug during measurement
    [CommandHandler.cpp, NomadBLDCGUI.py]
2020-03-30 Makefile Updates/Though I broke it... :/ All seems well now.
    [Motor.cpp, MotorController.cpp, NomadBLDCGUI.py, main.cpp]
2020-03-30 Fix Makefile, Change Interrupt Priorities
    [MotorController.cpp, main.cpp]
2020-03-30 Serial priority issue fixed. Still should probably disable in Commutation loop...
    [NomadBLDCGUI.py]
2020-03-30 Added UART disble/eanble wrappers on critical sections.
2020-03-31 Reworking structs. Reading back more config. Encoder offset calibration from GUI added.
    [CommandHandler.cpp, Commands.py, DataContainers.py, Motor.cpp, MotorController.cpp, MotorController.h, NomadBLDC.py, NomadBLDCGUI.py]
2020-04-01 Ready to start plotting. All calibration measurements tied in. Still need to pass data back before save.
2020-04-01 Comms issue out of nowhere.
    [Motor.cpp]
2020-04-01 Fixed Contorller Lockout Issue. Last few commits are bad.
    [Commands.py, Motor.cpp, Motor.h, MotorController.cpp, NomadBLDCGUI.py]
2020-04-02 State reading and fix comms lagout bugs.
    [CommandHandler.cpp, Commands.py, DataContainers.py, Motor.h, MotorController.cpp, MotorController.h, NomadBLDC.py, NomadBLDCGUI.py]
2020-04-05 Trying some Torque control graphs.
2020-04-07 Add RMS Current Limiter/Ring Buffer Class
2020-04-07 Change sub sample loop to moduluo for now
2020-04-08 Move some structs around Add RMS current limiting
2020-04-09 Add Current Control and some load testing code
2020-04-17 Pre branch to switch away MBED
2020-06-28 Add Robot URDF
    [Nomad.urdf, b_foot_FL.stl, b_foot_FR.stl, b_foot_RL.stl, b_foot_RR.stl, b_haa_motor_FL.stl, b_haa_motor_FR.stl, b_haa_motor_RL.stl]
2020-06-28 Work on leg controller
2020-06-28 Working on leg controller.
2020-06-29 More Leg Controller Working
2020-07-01 Got weird vtable issue to fix
    [NomadControl.cpp, NomadControl.hpp, NomadControlFSM.cpp]
2020-07-02 Fix vtable issue. Starting to add control states
    [NomadControl.cpp, NomadControl.hpp, NomadControlFSM.cpp, OffState.cpp]
2020-07-03 Working on Kinematics/Dynamics Task
2020-07-17 Work on gazebo loading
    [Nomad.urdf, b_foot_FL.stl, b_foot_FR.stl, b_foot_RL.stl, b_foot_RR.stl, b_haa_motor_FL.stl, b_haa_motor_FR.stl, b_haa_motor_RL.stl]
2020-07-20 Working on sim.
    [Nomad.urdf]
2020-07-20 Fix sim compile issue. Starting ZCM
    [main.cpp]
2020-07-22 Collision URDF improvements
    [Nomad.urdf]
2020-07-22 More collsions
    [Nomad.urdf]
2020-07-22 Simplifed URDF collision model is complete (good enough)
    [Nomad.urdf]
2020-07-22 Simulation Interface is Connected to Simulation
    [Nomad.sdf, Nomad.urdf]
2020-07-28 Work on estimators.
    [Nomad.urdf]
2020-07-29 Begin Port refactoring. Switching back to less generic types
2020-08-05 Add Leg control message
2020-08-06 Reverted. Need to refactor parents/ports
    [NomadControl.cpp, NomadControl.hpp, NomadControlFSM.cpp, StandState.cpp]
2020-08-09 A bit broken. Working on control instability.
    [FusedLegKinematicsStateEstimator.cpp, LegController.cpp, LegController.hpp, NomadControlFSM.cpp, NomadDynamics.cpp, NomadRobot.cpp]
2020-08-10 UDP Jitter needs fixing.
    [main.cpp]
2020-08-12 New native thread port added.
2020-08-13 Added Native Threading. May still be some issues with RT scheduling.
    [RealTimeTask.cpp, RealTimeTask.hpp]
2020-08-14 Better, still some issues.
    [FusedLegKinematicsStateEstimator.cpp, LegController.cpp, NomadControlFSM.cpp, NomadDynamics.cpp, NomadRobot.cpp, SimulationInterface.cpp]
2020-08-16 Change out timer code for better efficiency. System Block Diagrams coming along.
2020-08-17 Add varying sample rates
2020-08-18 Working on graph. Still need FSM and Leg Control
2020-08-19 Conver the leg controller task. Next is teleop
2020-08-21 QP Framework started for solvers
2020-08-23 QP almost there. Couple of bugs. Branch to fix.
    [RigidBodyGRFSolverQP.cpp, StandState.cpp]
2020-08-24 Fixed. Was a row/col order issue on non-symmetric constraints matrix A_qp
    [RigidBodyGRFSolverQP.cpp, StandState.cpp]
2020-08-25 Working on Rotated Yaw Coordinates
2020-08-26 Still ahve issues with rotated yaw...
    [NomadDynamics.cpp, NomadRobot.cpp, RigidBodyGRFSolverQP.cpp, StandState.cpp, main.cpp]
2020-08-27 This commit was all testing and can be undid...
    [Nomad.urdf]
2020-08-28 Problem between base link and body_node
    [NomadRobot.cpp, main.cpp]
2020-08-28 A little cleanup. But still lost qp stability
    [Nomad.urdf]
2020-08-29 FINALLY tracked down all the issues. And balance contorller working in all orientations!!
    [FusedLegKinematicsStateEstimator.cpp, NomadDynamics.cpp, NomadRobot.cpp, RigidBodyGRFSolverQP.cpp, SimulationInterface.cpp, StandState.cpp, main.cpp]
2020-09-02 Start G4 Firmware for next iteration of BLDC
2020-09-09 Getting Threads in
2020-09-10 Need to map interrupts better
2020-09-13 Ready to get UART Working
2020-09-14 UART DMA RX Working.
2020-09-15 Starting on UART Peripheral Interface
2020-09-16 Fix ISR Bug. USART is ready to roll now.
    [FirmwareG4.ioc, shared.h, uart.cpp]
2020-09-16 Add HDLC and CRC to UART
2020-09-17 Switch to main.cpp
2020-09-17 Revert "Switch to main.cpp"
    This reverts commit a9136359729a6ba152ebebcd219671c8d000e1a1.
    [FirmwareG4.ioc, main.cpp]
2020-09-18 Proper RTOS/C++ Bringup. Ends up being a HEAP size issue
    [FirmwareG4.ioc, LEDService.cpp, LEDService.h, nomad_app.cpp, nomad_app.h]
2020-09-19 Fix LED Queue. Works great now.
    [CommandHandler.h, LEDService.cpp, LEDService.h, nomad_app.cpp]
2020-09-21 Got Position Sensor SPI Working
2020-09-22 Start DRV SPI Driver
2020-09-22 Updating DRV8323 driver
2020-09-23 Finish DRV8323 Driver
2020-09-23 Fix bugs. Need to reverify defaults
    [DRV8323.cpp, DRV8323.h]
2020-09-24 DRV Working Correctly. Start Adding Motor Objects
    [DRV8323.cpp, DRV8323.h, FirmwareG4.ioc, Motor.cpp, Motor.h, MotorController.cpp, MotorController.h]
2020-09-24 Update LED Tasks
2020-09-24 Fixing Timers
2020-09-24 ADC/Timers Ready for Testing
2020-09-26 Timer Testing
2020-09-26 More Timer Updates
2020-09-26 Update CubeMX for ADC
2020-09-27 Working on ADC
2020-09-27 Trying to track down LL ADC Issue
2020-09-27 ADC Works with HAL. Will attempt LL again.
2020-09-27 HAL/LL Working. Now try to isolate LL issue
    [nomad_app.cpp]
2020-09-27 LL ADC. About to tie back in to timers
2020-09-28 Final Commit of Day. Fix ADC accuracy bug with vbus
    [DRV8323.cpp, FirmwareG4.ioc, MotorController.cpp, nomad_app.cpp]
2020-09-28 Fix Phase Ordering in SetDuty
    [MotorController.cpp]
2020-09-29 Fix DRV Enable/Disable. Misc. Cleaup.
    [DRV8323.cpp, DRV8323.h, Motor.cpp, MotorController.cpp, nomad_app.cpp]
2020-10-01 Start UART refactor to CPP
2020-10-02 BROKE. Working on new UART
    [nomad_app.cpp]
2020-10-04 Progress on CPP conversion of UART
2020-10-04 C++ UART Done. Need HDLC receive/callback handle.
2020-10-13 Add HDLC Frame handler to UART
2020-10-14 HDLC and UI working Now. Refactor UART. Fix measurement updates
    [CommandHandler.cpp, CommandHandler.h, DataContainers.py, Logger.cpp, Logger.h, Motor.cpp, MotorController.cpp, NomadBLDCGUI.py]
2020-10-16 Add Thermistor Class
2020-10-16 Thermistor Compute Function
2020-10-16 Thermistor Object Working.
2020-10-17 Compile fix for previous commit
    [MotorController.cpp]
2020-10-17 Replace arm math functions
    [MotorController.cpp, RMSCurrentLimiter.cpp, nomad_app.cpp]
2020-10-20 Starting ADC Perifpheral
2020-10-20 ADC Finished. Need Testing.
2020-10-21 Good push for the ADC peripheral. Further refactoring of the Motor Controller and removing lots of old globals
2020-10-21 Updates to ADC and Refactoring
2020-10-22 Fixed ADC Bugs/Peripheral is Functional TIL ADC Overrun implications... FSM code is working
    [CalibrationStates.cpp, CalibrationStates.h, IdleState.cpp, MotorController.cpp, NomadBLDCData.h, NomadBLDCFSM.cpp, NomadBLDCFSM.h, NomadBLDCGUI.py]
2020-10-23 Encoder Offset Calibration Added Updated FSM Functionality Cleanup ADC
2020-10-23 Add FOC Voltage. Something is broken here...
    [CalibrationStates.cpp, ErrorState.cpp, ErrorState.h, FOCState.cpp, FOCState.h, MotorController.cpp, NomadBLDCFSM.cpp, nomad_app.cpp]
2020-10-24 FIX Complte PITA that caused pole pairs to be incorrect. REMOVE CCM for now. Seems to have some weird allocation issues
    [FOCState.cpp, Motor.cpp, Motor.h, MotorController.cpp, MotorController.h, PositionSensor.h]
2020-10-26 Add SPI Concurrency
2020-10-27 Was current sense noise with split start/end position sensor reads. Remved for now.
    [Motor.cpp, Motor.h, MotorController.cpp, PositionSensor.cpp]
2020-10-27 Add Bus Current
2020-10-28 Bus Current is added back/working.
2020-10-28 Fixed point math tested.
    [MotorController.cpp]
2020-10-28 Bug fix with null/lockup error on cold boot
    [MotorController.cpp, nomad_app.cpp]
2020-11-02 CAN BUG FIXED!! Damn you CubeMX!!!
    [nomad_app.cpp]
2020-11-02 Increase Bitrate for testing. May or may not work
    [nomad_app.cpp]
2020-11-07 Interrupts not quite working.
2020-11-07 Still have interrupt problems. Trying some refactor
    [fdcan.cpp, nomad_app.cpp]
2020-11-07 Interrupts working. Now adding Callbacks
2020-11-15 Add device status Register
2020-11-15 Add More Registers. Also probably broke the GUI Serial Protocol
    [Motor.cpp, MotorController.cpp, MotorController.h, PositionSensor.h, RegisterInterface.h, nomad_app.cpp]
2020-11-15 Got socketcan working. Ready for PC Control->BLDC loop testing.
2020-11-18 Add Motor Controller Config Registers
2020-11-22 Reset back to neutral defaults. Update TODO.
    [Motor.cpp, MotorController.cpp, PositionSensor.cpp, PositionSensor.h]
2021-01-20 Fix Allocation Bug. Still should move encoder calibration -> PC Side.
    [CalibrationStates.cpp, CalibrationStates.h, MotorController.cpp, PositionSensor.cpp]
2021-03-03 Fix Phase Order instability bug. Make sure to get this in master.
    [MotorController.cpp]
2021-03-04 Swap up some configs. Implement Position Limits.
    [DataContainers.py, MotorController.cpp, MotorController.h, NomadBLDCGUI.py, RegisterInterface.h]
2021-03-05 Gear ratio fix for mechanical position.
    [Motor.cpp, MotorController.cpp]
2021-03-09 Getting some more commands going. Bug Fixes
    [MotorController.cpp, MotorController.h, NomadBLDCGUI.py, RegisterInterface.cpp, RegisterInterface.h, Registers.h, fdcan.cpp]
2021-03-13 Fix Python Config Read
    [CommandHandler.cpp, Commands.py, Logger.cpp, MotorController.cpp, NomadBLDCGUI.py, nomad_app.cpp]
2021-03-15 Progress. Could be brokeen.
    [Motor.cpp, Motor.h, MotorController.cpp, MotorController.h, RegisterInterface.cpp, RegisterInterface.h]
2021-03-16 Add an optimized close loop current mode Add function callbacks for registers
2021-03-16 Starting to test multiple devices on bus
2021-03-16 coupled joint test
2021-03-17 Buggy include refactor. Passing register cmd now bit cleaner.
    [CalibrationStates.cpp, CommandHandler.cpp, CommandHandler.h, Logger.h, MotorController.cpp, MotorController.h, RegisterInterface.cpp, RegisterInterface.h]
2021-03-19 Add PCAN class. Working on filtering
2021-03-19 Add torque limiting
2021-03-20 Add SocketCAN. Starting NomadLBDC Lib
2021-03-21 CAN Device updates. Start Nomad Library
2021-03-21 Bug fixes. Misc Updates. Getting more usable/stable
    [Logger.cpp, Motor.cpp, MotorController.cpp, NomadBLDC.cpp, NomadBLDC.h, PositionSensor.cpp, nomadbldc_test.cpp]
2021-03-24 Time for a small refactor to servo wrapper class. Fix Save return code bug.
    [CommandHandler.cpp, NomadBLDC.cpp, NomadBLDC.h, RegisterInterface.cpp, nomad_app.cpp]
2021-03-24 Better Async support for servo
2021-03-25 Add Torque mode more tweaks.
2021-03-25 Add Bus Status. Preventt control mode if position limit is activated. Add bit timing config
    [FOCState.cpp, NomadBLDC.h]
2021-03-25 Add additional motor to telepresense test
2021-04-01 Position and Velocity loops working decent
2021-04-03 Add 2 dof leg model
    [HFE_Actuator1.stl, KFE_Actuaor1.stl, Leg.urdf, Lower_Leg1.stl, Slider_Plate1.stl, Upper_Leg1.stl, base_link.stl]
2021-04-04 Update Test Leg URDF
    [Foot1.stl, Leg.urdf, Lower_Leg1.stl]
2021-04-05 Sin Circle Sweep ready to test.
    [Foot1.stl, KFE_Actuaor1.stl, Leg Old.urdf, Lower_Leg1.stl, Slider_Plate1_1.stl, Upper_Leg1.stl]
2021-04-12 Jump Test Working! Need to fix reply bug on write
    [Leg.urdf]
2021-04-21 Update URDF
    [Leg.urdf]
2021-04-23 Add V2 NOMAD URDF Files w/ DAE
    [NOMAD.urdf, b_foot_FL1.stl, b_foot_FR1.stl, b_foot_RL1.stl, b_foot_RL2.stl, b_haa_motor_FL1.stl, b_haa_motor_FR1.stl, b_haa_motor_RL1.stl]
2021-04-27 Adjust Collision Model on URDF
    [NOMAD.urdf]
2021-04-27 Full Test of new URDF + Stand.
    [NOMAD.urdf]
2021-04-29 Add Watchdog Timers back. Adjust URDF
    [NOMAD.urdf]
2021-04-29 Add yaml-cpp
    [robot-config.yaml]
2021-05-04 Working on port mapping [BROKEN]
    [RealTimeTask.cpp]
2022-03-20 Add background socket worker
