implementedrobotics/Nomad/(notices)

Notices in the files:
Hardware/Actuator/NomadBLDC/FirmwareG4/NomadBLDC/include/NomadFlash.h:
Copyright (c) <2021> <Quincy Jones - quincy@implementedrobotics.com/>
Hardware/Actuator/NomadBLDC/FirmwareG4/Core/Inc/main.h:
© Copyright (c) 2020 STMicroelectronics.
All rights reserved.
This software component is licensed by ST under Ultimate Liberty license
(C) COPYRIGHT STMicroelectronics *****END OF FILE
